jrleeman/NSSL_EFM/Hardware/Analog_PCB/Renders/PCB_Back.png

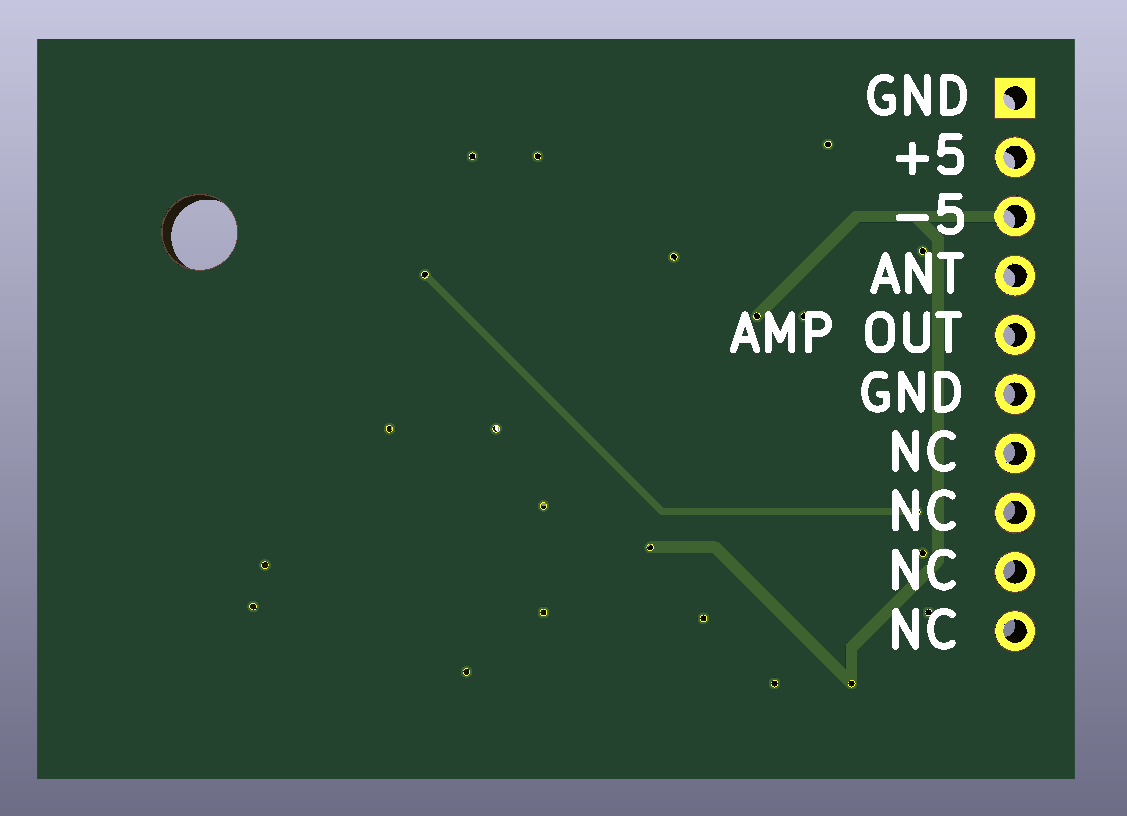
Hardware/Analog_PCB/Renders/PCB_Back.png
