jrleeman/NSSL_EFM/Hardware/Analog_PCB/Renders/PCB_Front.png

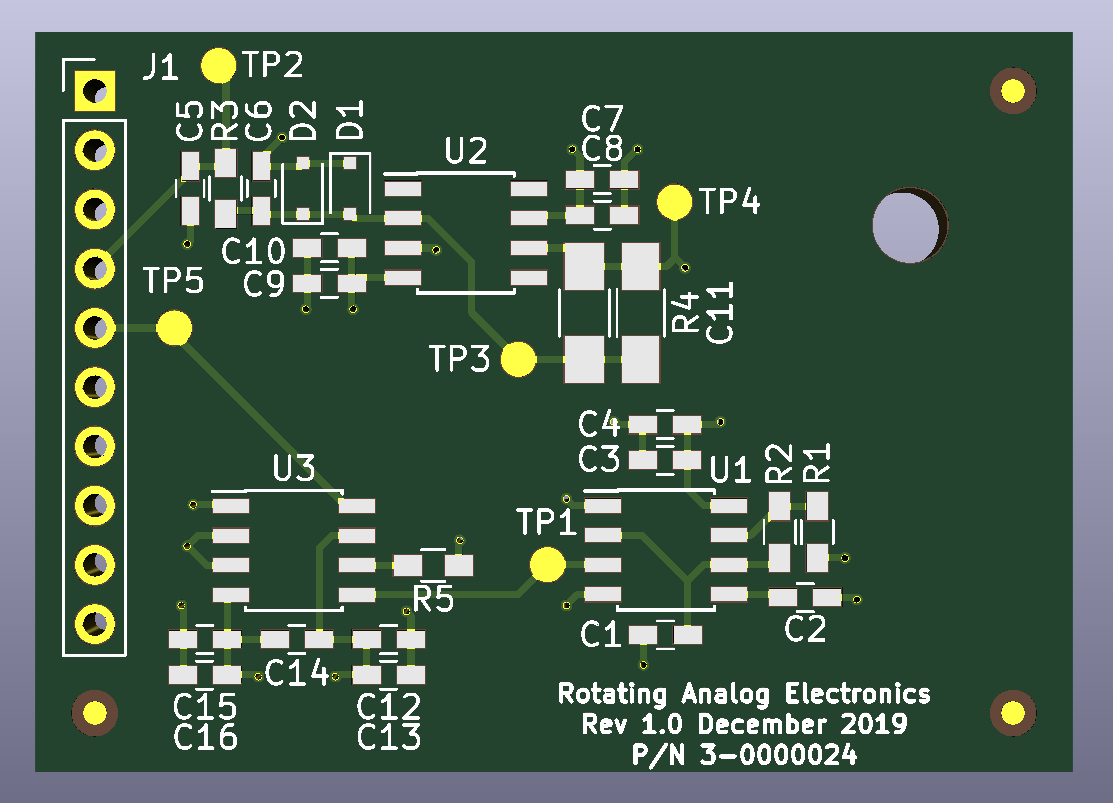
Hardware/Analog_PCB/Renders/PCB_Front.png
