jrleeman/NSSL_EFM/Hardware/Battery_PCB/Renders/PCB_Back.png

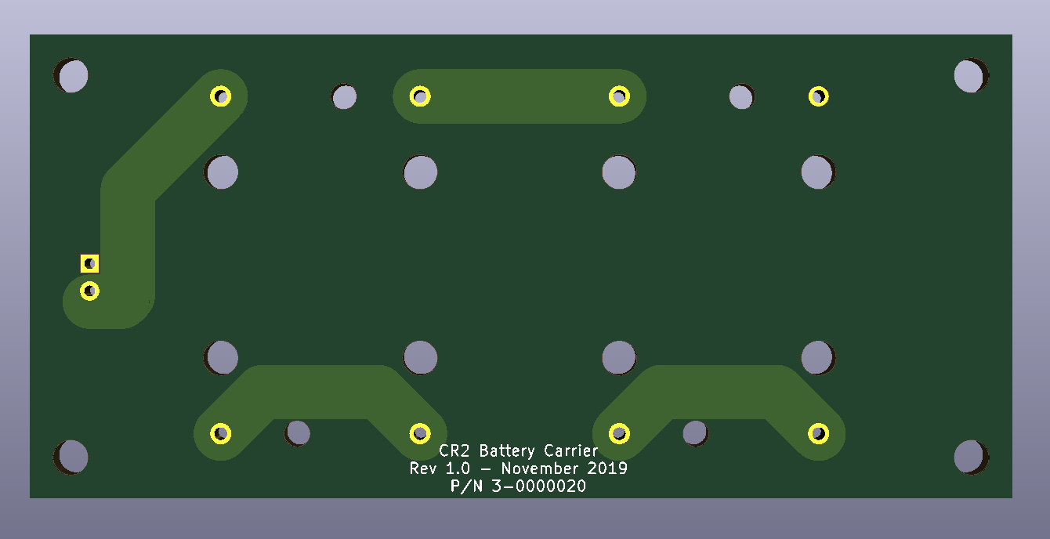
Hardware/Battery_PCB/Renders/PCB_Back.png
