jrleeman/NSSL_EFM/Hardware/Battery_PCB/Renders/PCB_Front.png

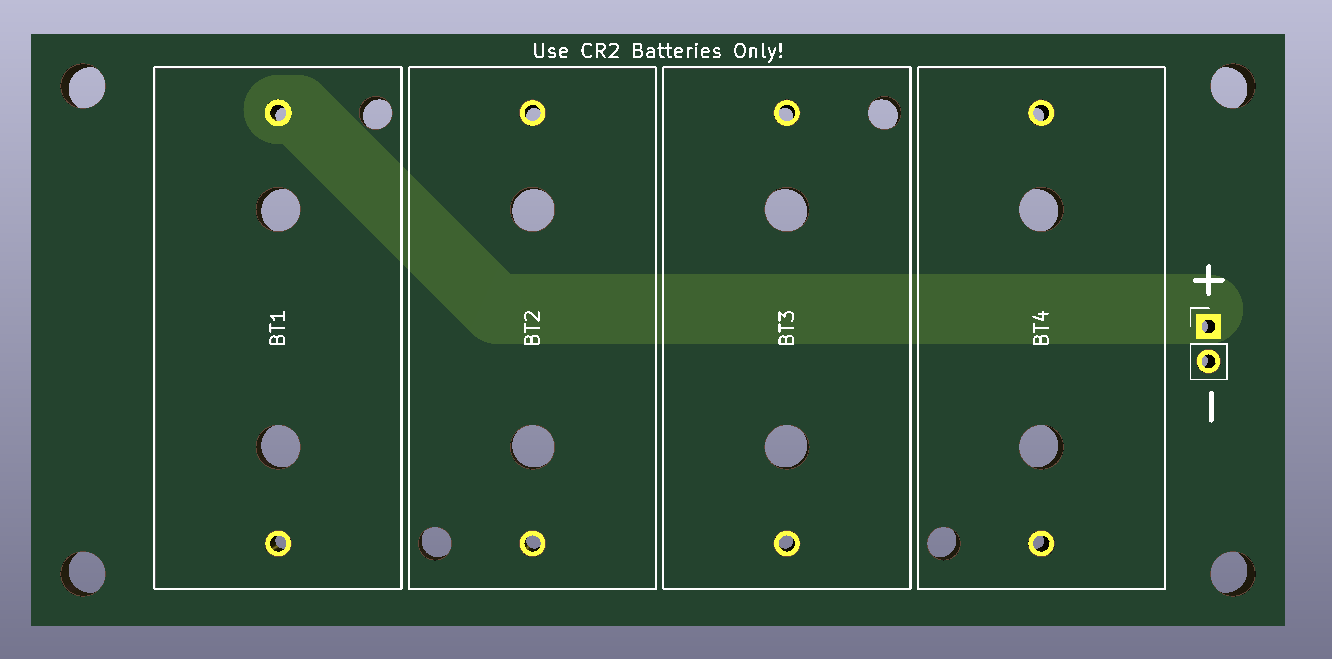
Hardware/Battery_PCB/Renders/PCB_Front.png
