jrleeman/NSSL_EFM/Hardware/Control_PCB/Renders/PCB_Back.png

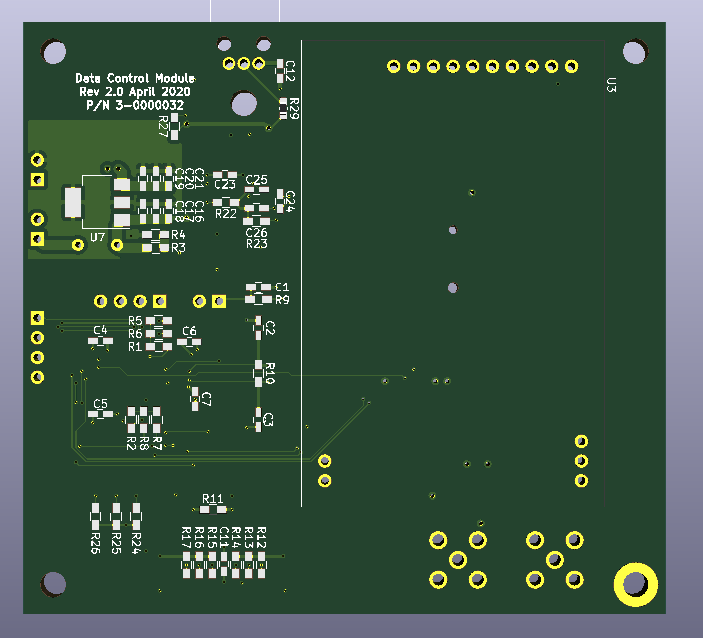
Hardware/Control_PCB/Renders/PCB_Back.png
