jrleeman/NSSL_EFM/Hardware/Control_PCB/Renders/PCB_Front.png

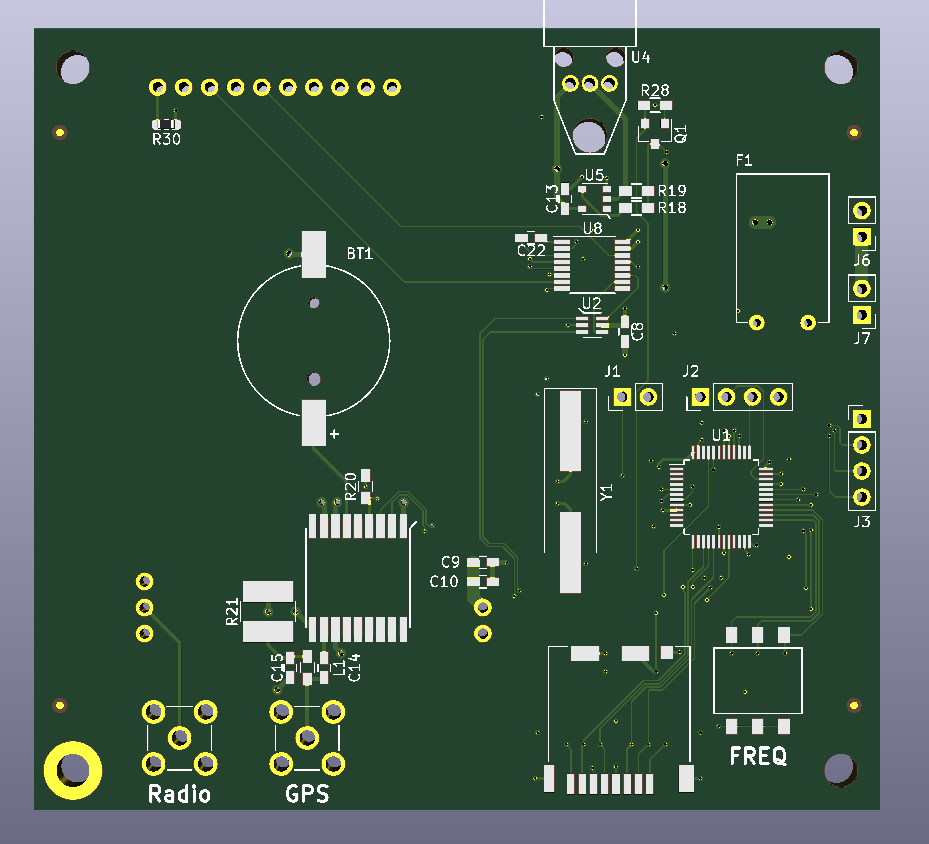
Hardware/Control_PCB/Renders/PCB_Front.png
