jrleeman/NSSL_EFM/Hardware/Cutdown_PCB/Renders/PCB_Back.png

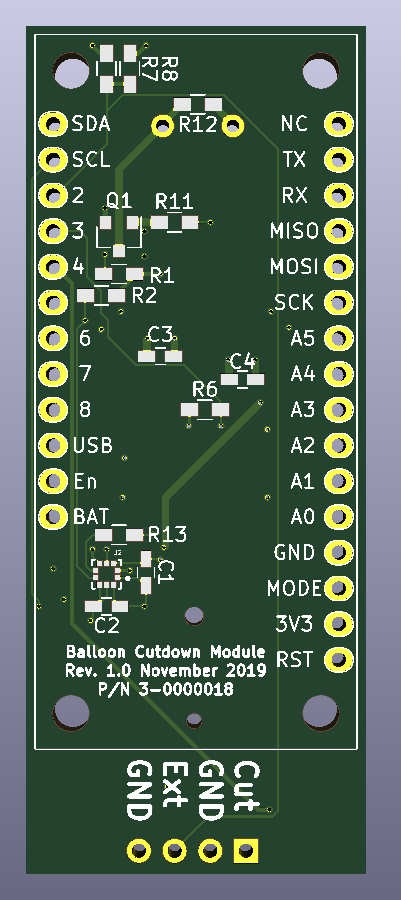
Hardware/Cutdown_PCB/Renders/PCB_Back.png
