jrleeman/NSSL_EFM/Hardware/Cutdown_PCB/Renders/PCB_Front.png

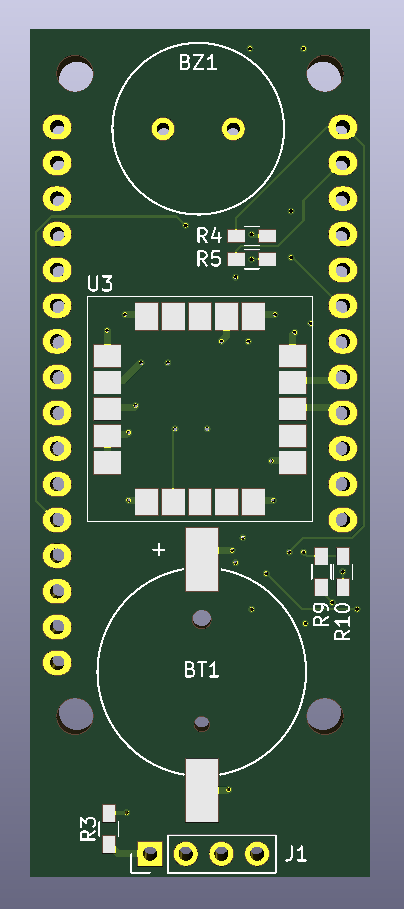
Hardware/Cutdown_PCB/Renders/PCB_Front.png
