jrleeman/NSSL_EFM/Hardware/Cutdown_Power_PCB/Renders/PCB_Back.png

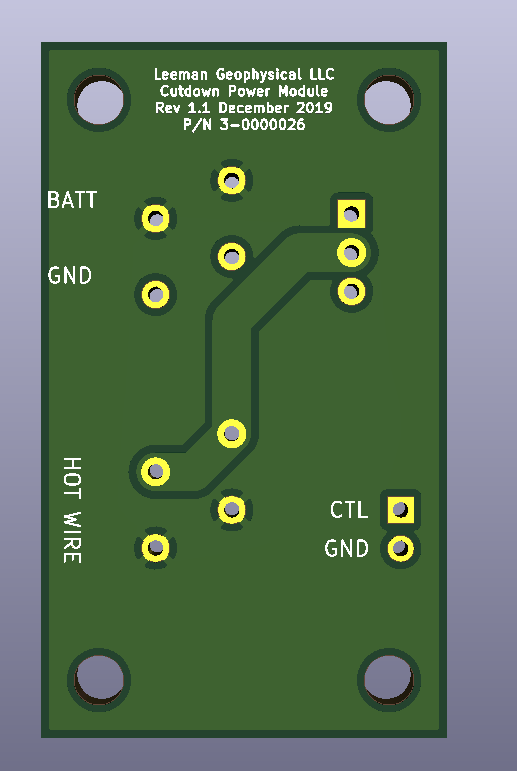
Hardware/Cutdown_Power_PCB/Renders/PCB_Back.png
