jrleeman/NSSL_EFM/Hardware/Cutdown_Power_PCB/Renders/PCB_Front.png

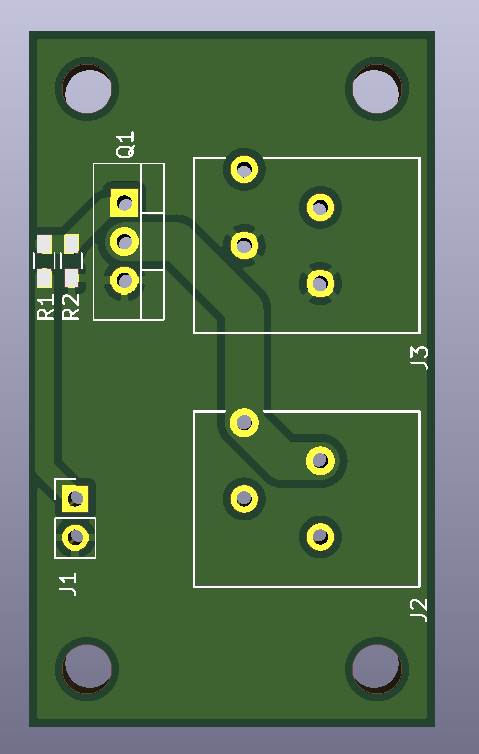
Hardware/Cutdown_Power_PCB/Renders/PCB_Front.png
