jrleeman/NSSL_EFM/Hardware/Digital_PCB/Renders/PCB_Back.png

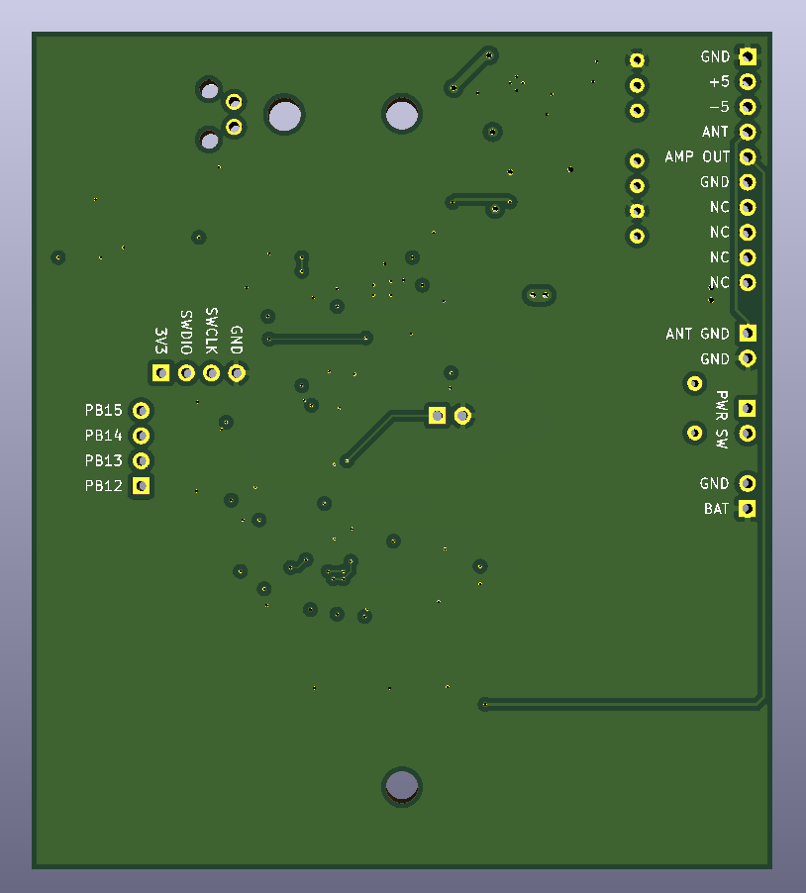
Hardware/Digital_PCB/Renders/PCB_Back.png
