jrleeman/NSSL_EFM/Hardware/Digital_PCB/Renders/PCB_Front.png

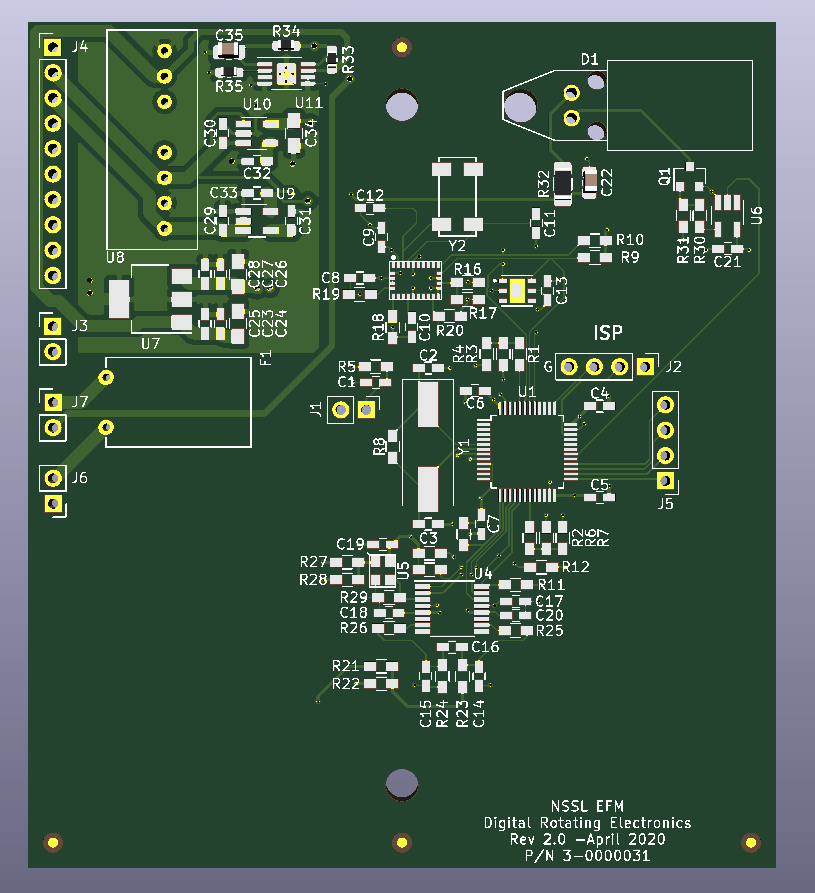
Hardware/Digital_PCB/Renders/PCB_Front.png
