jrleeman/NSSL_EFM/Hardware/Motor_Control_PCB/Renders/PCB_Back.png

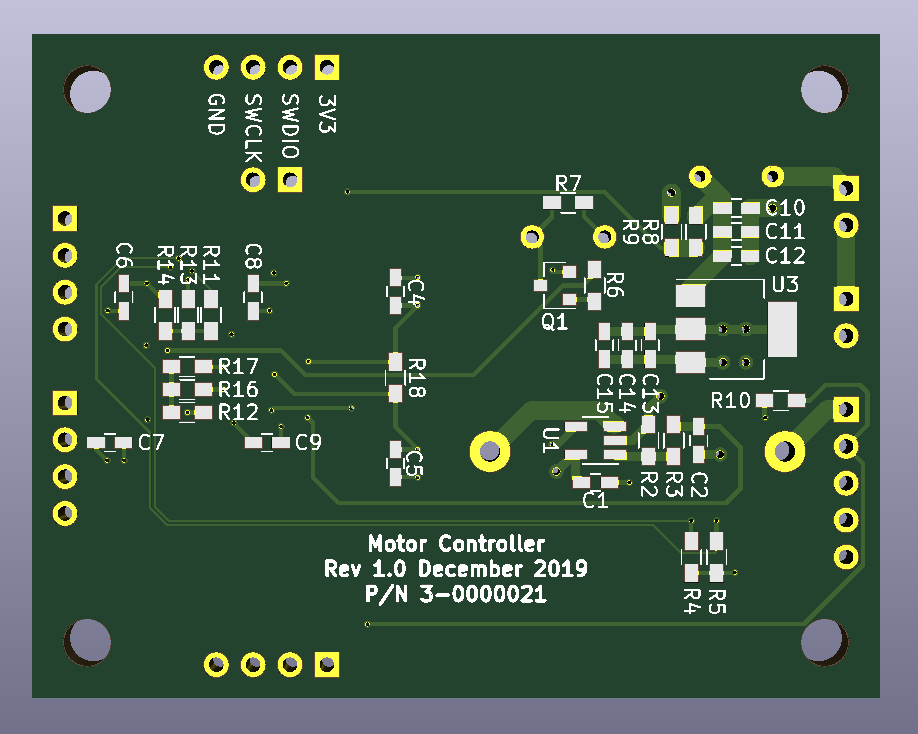
Hardware/Motor_Control_PCB/Renders/PCB_Back.png
