jrleeman/NSSL_EFM/Hardware/Motor_Control_PCB/Renders/PCB_Front.png

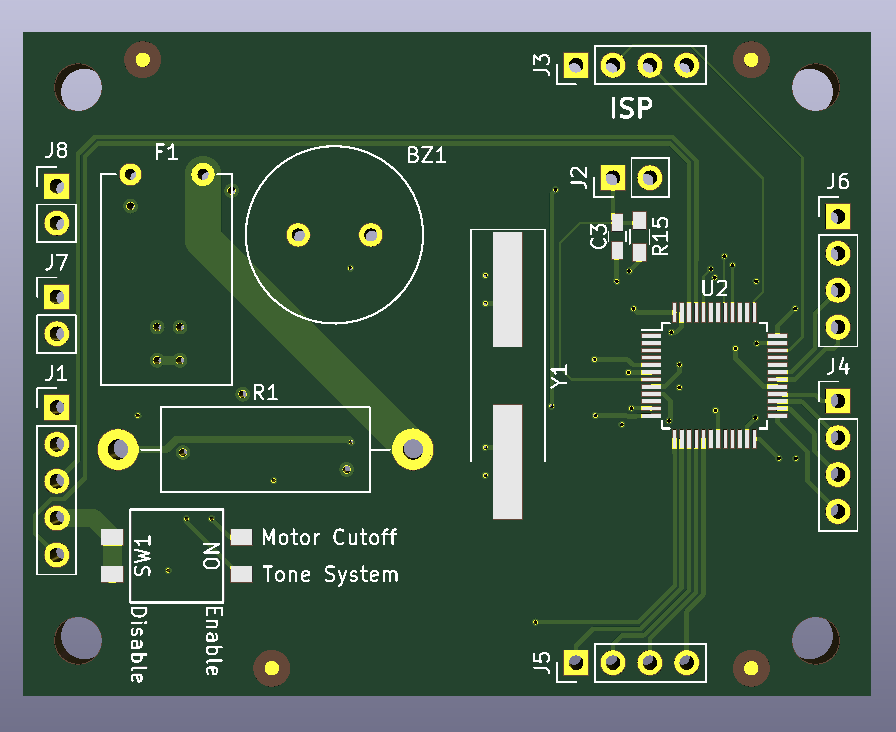
Hardware/Motor_Control_PCB/Renders/PCB_Front.png
