jrleeman/NSSL_EFM/Hardware/Digital_PCB/PDFs/pcb.pdf

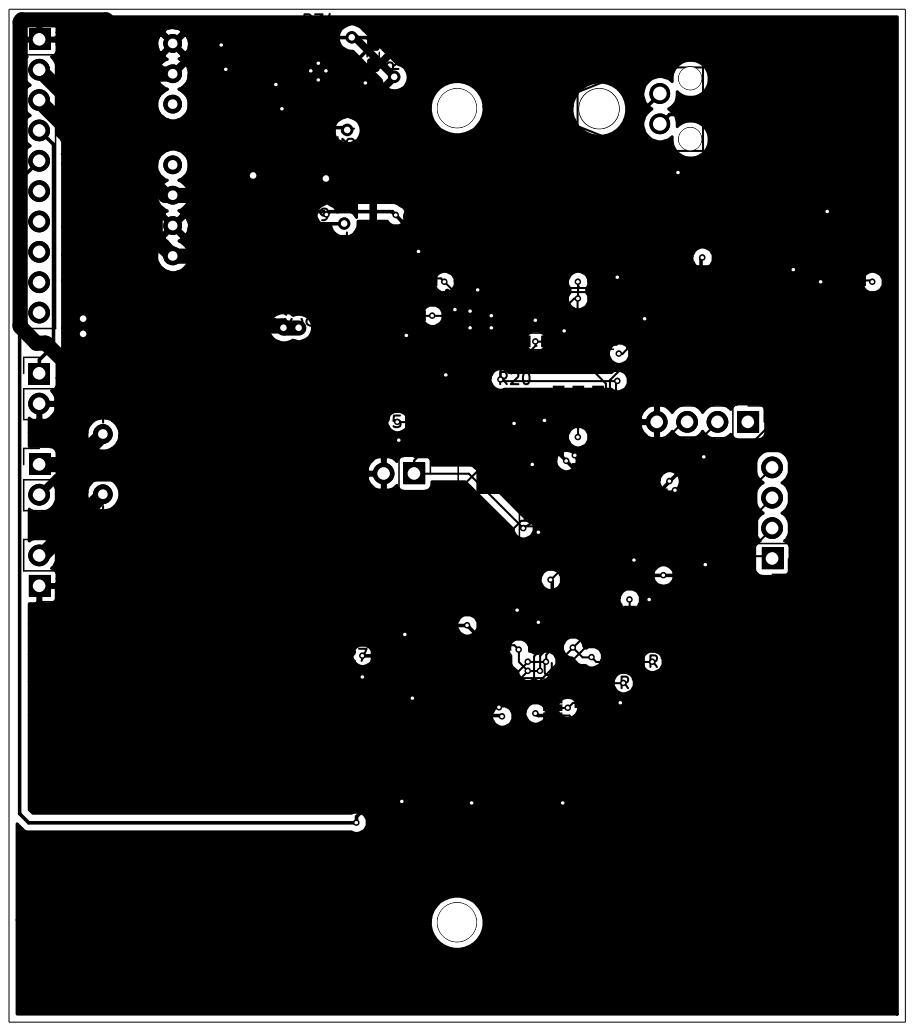
[picture p15: page 1]
