jrleeman/NSSL_EFM/Hardware/Control_PCB/PDFs/pcb.pdf

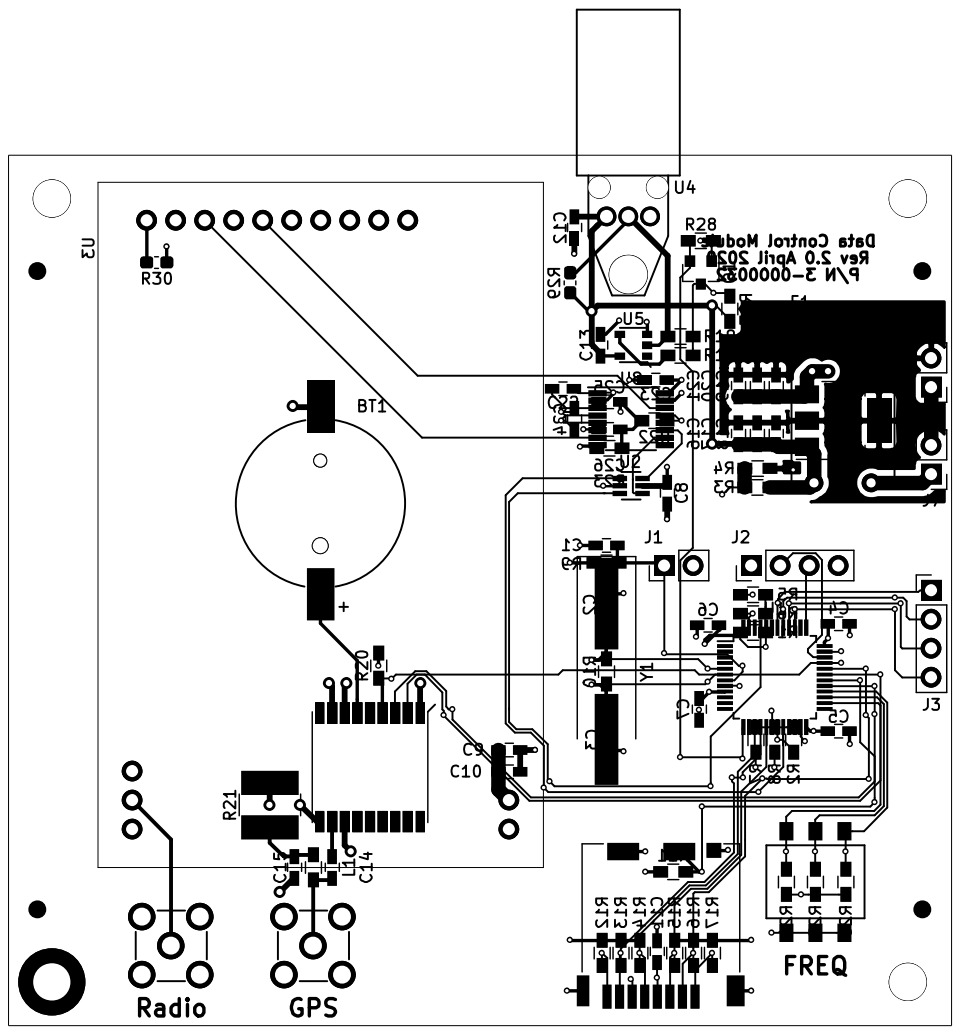
[picture p21: page 1]
