jrleeman/NSSL_EFM/Hardware/Cutdown_PCB/PDFs/schematic.pdf

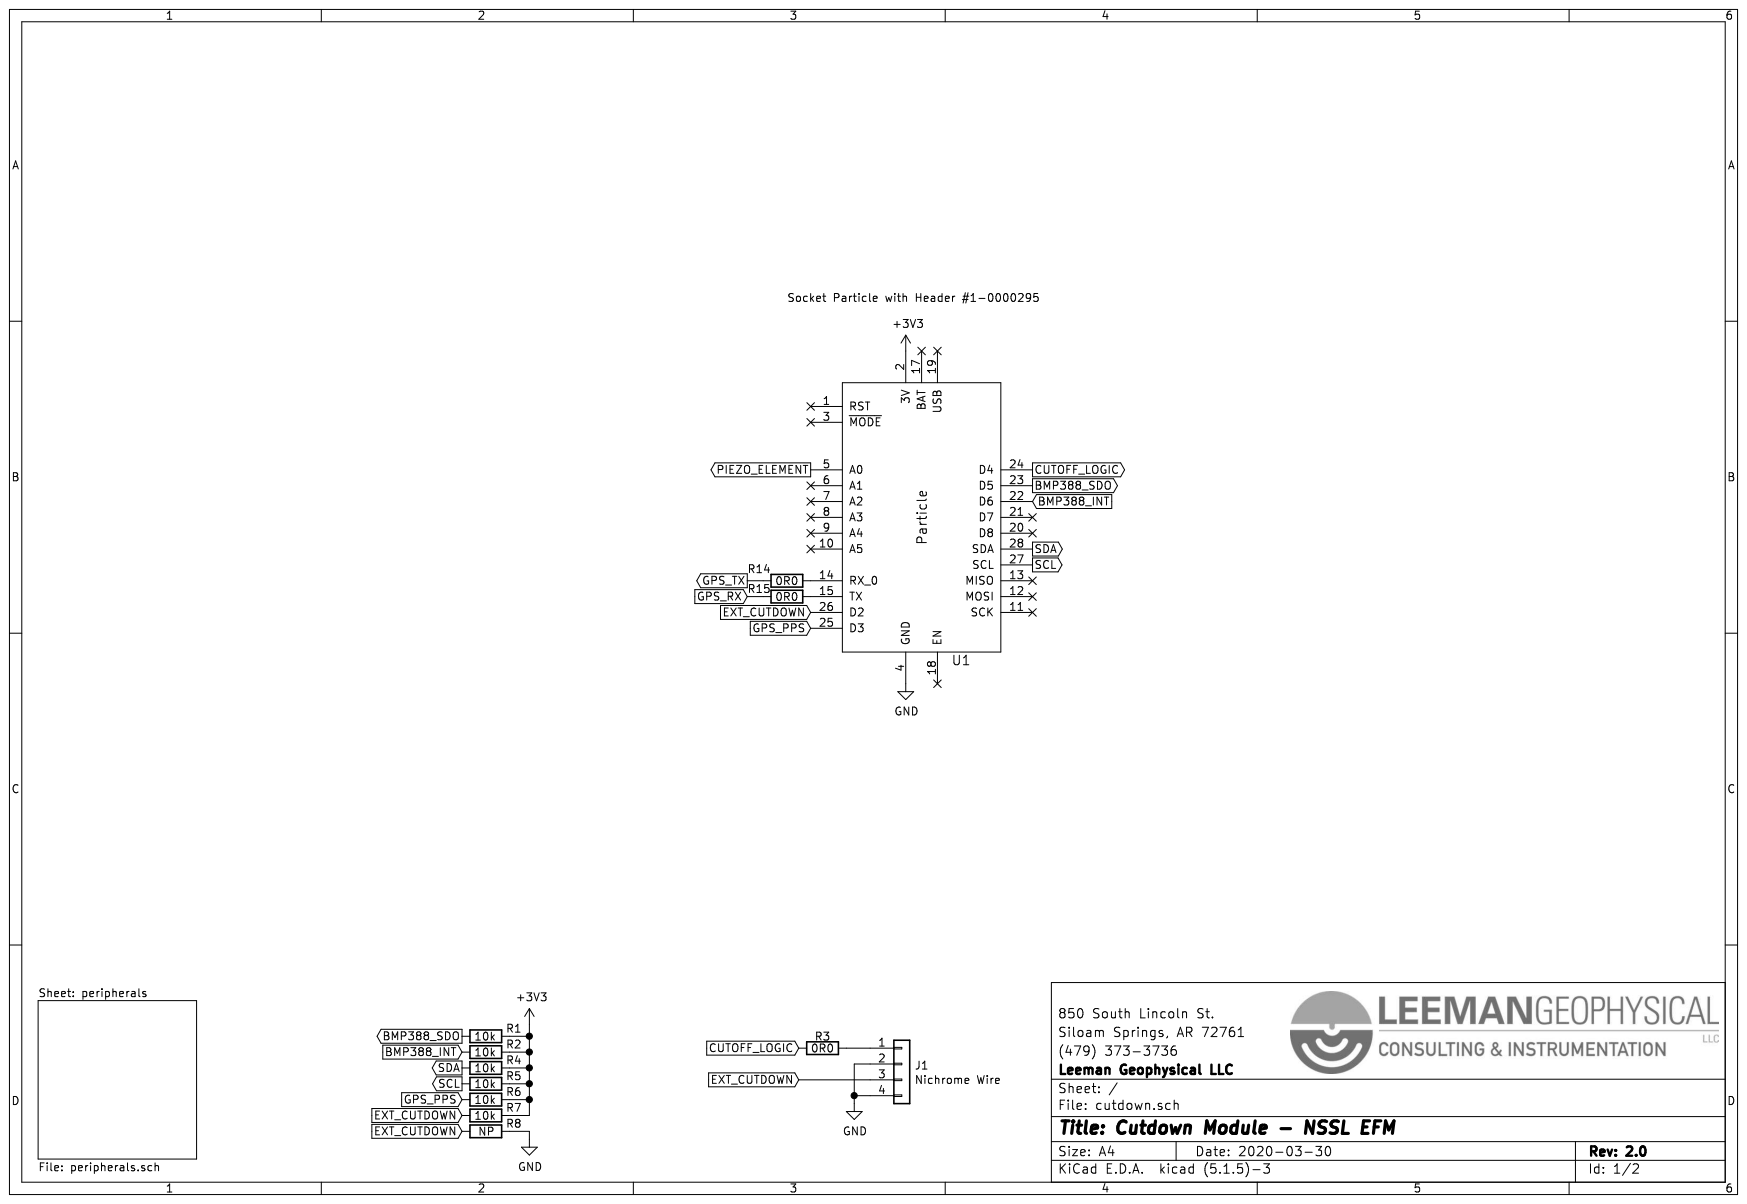
[picture p28: page 1]

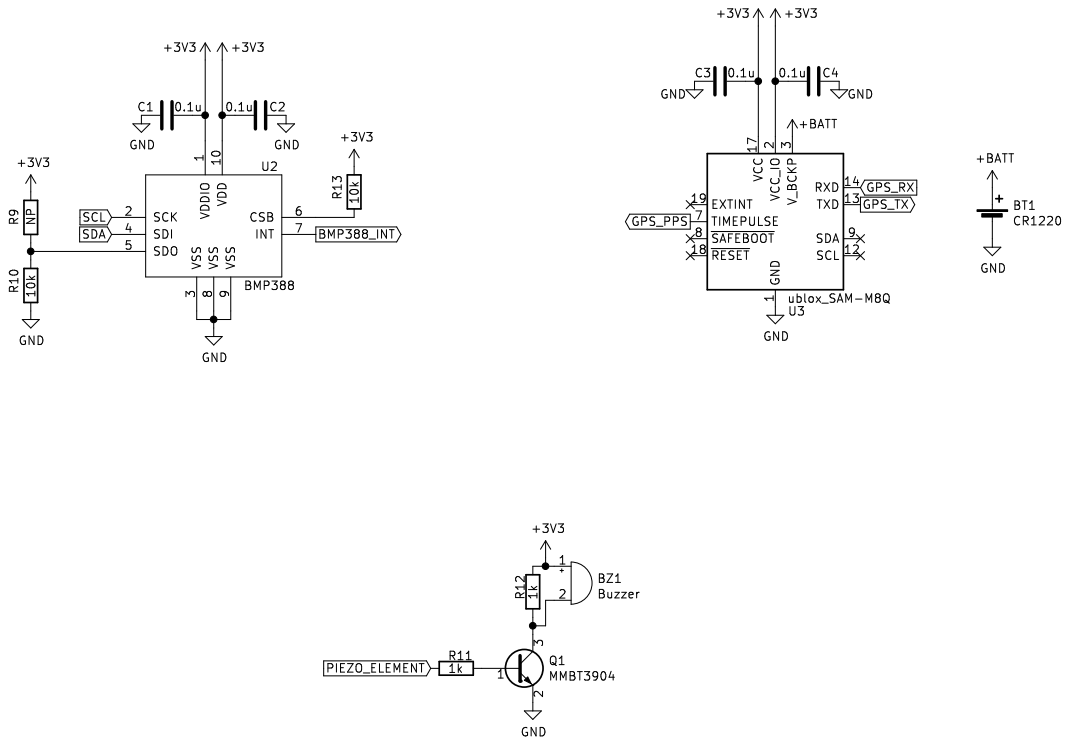
[picture p29: page 2]
