jrleeman/NSSL_EFM/Hardware/Analog_PCB/PDFs/pcb.pdf

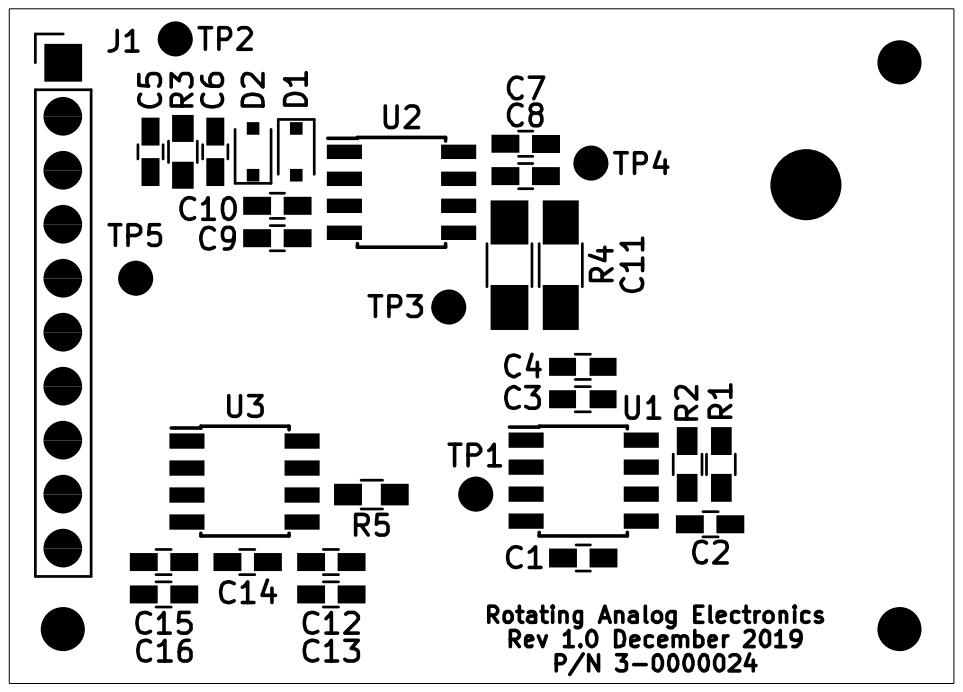
[picture p30: page 1]
