jrleeman/NSSL_EFM/Hardware/Analog_PCB/PDFs/schematic.pdf

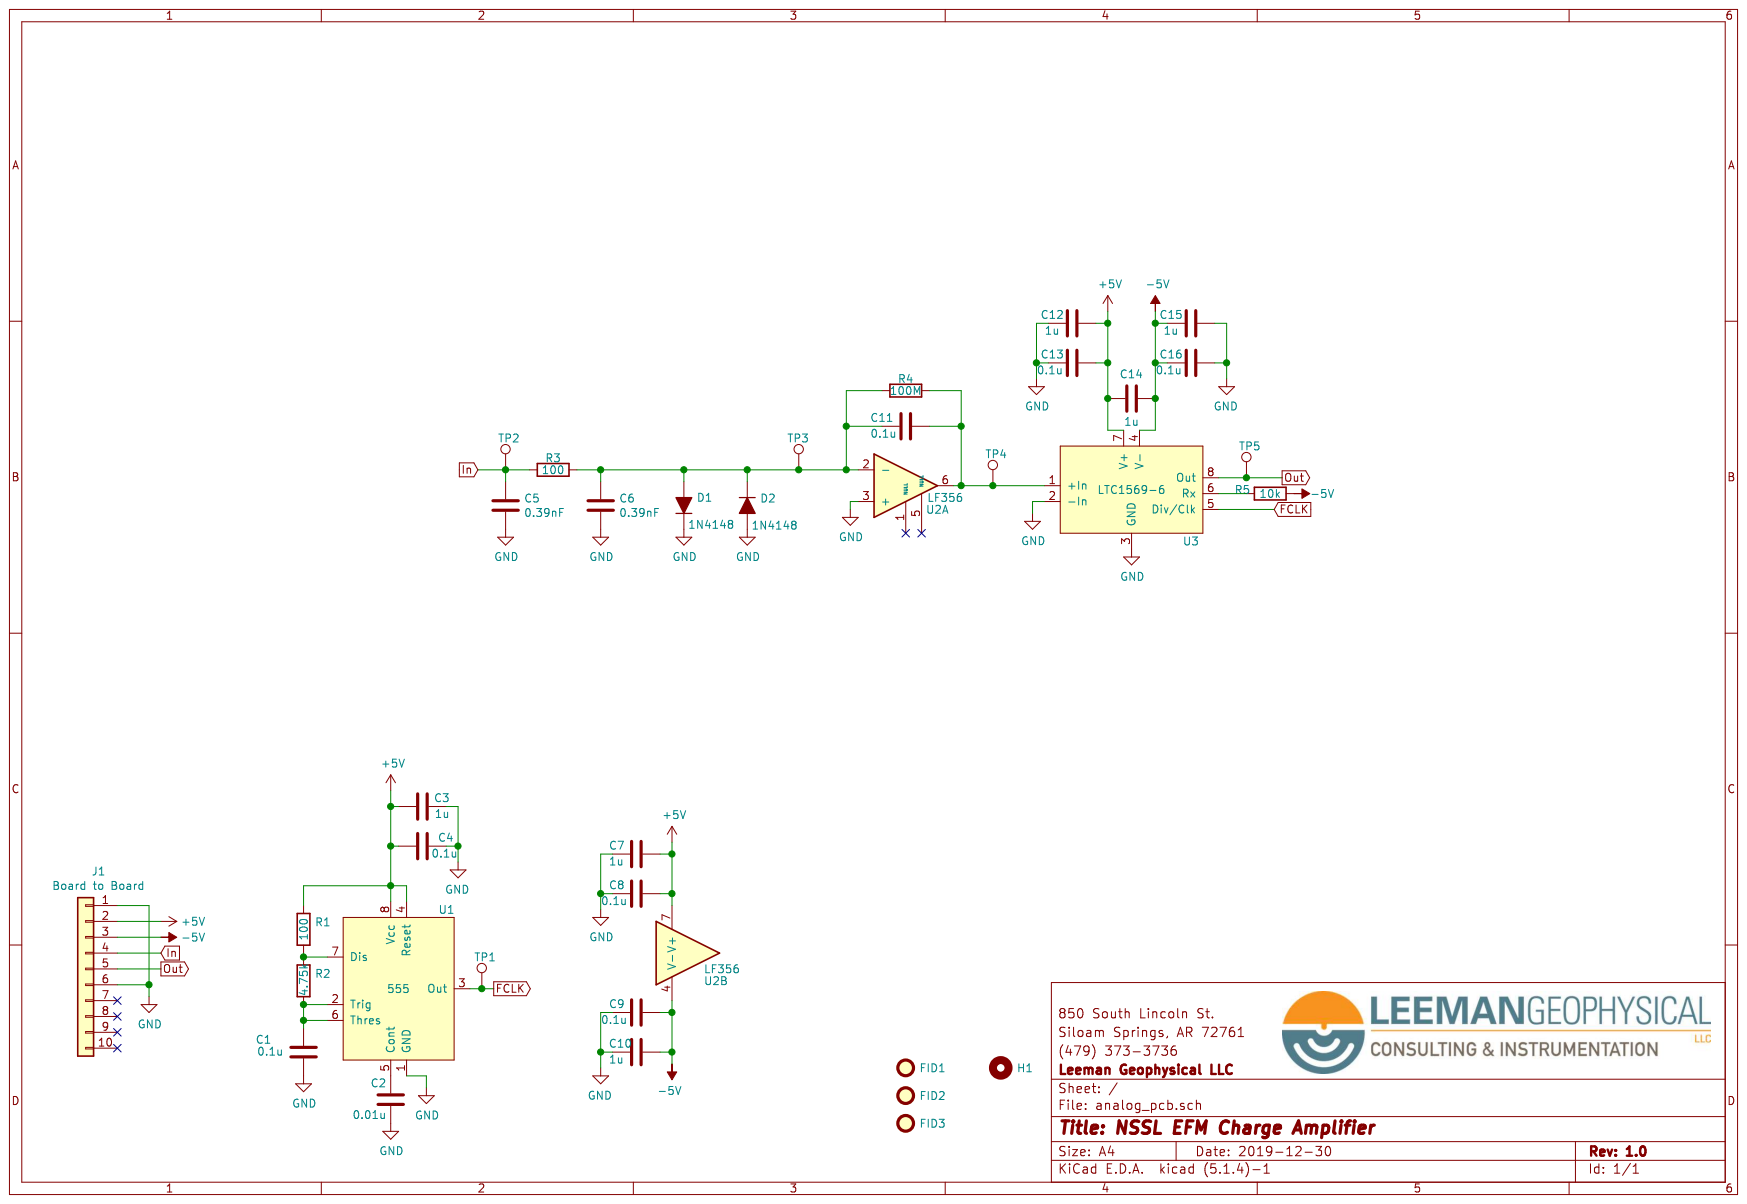
[picture p31: page 1]
