jrleeman/NSSL_EFM/Hardware/Cutdown_Power_PCB/PDFs/schematic.pdf

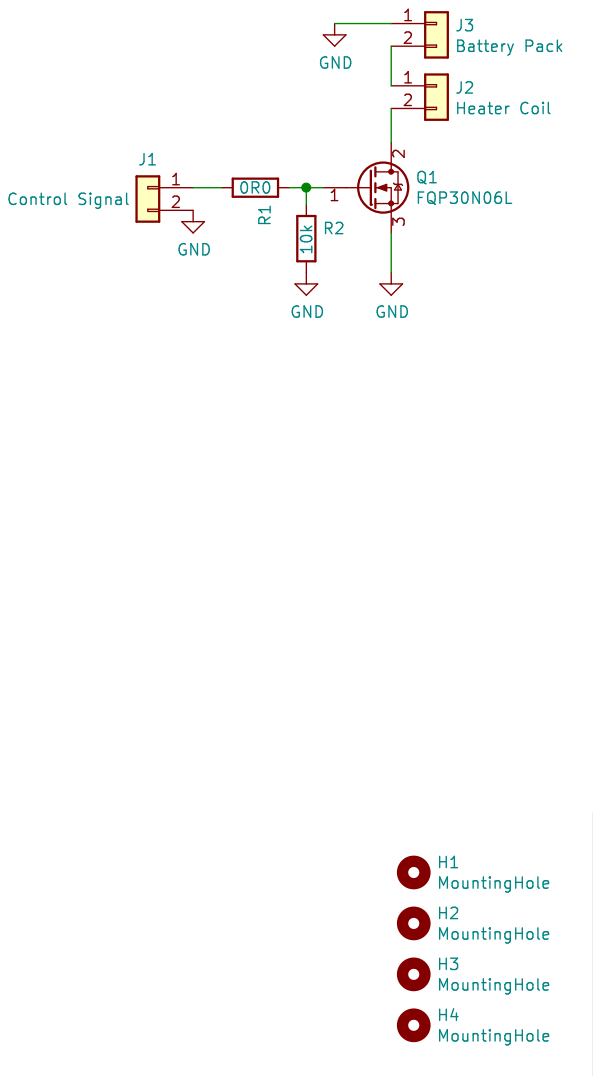
[picture p32: page 1]
