jrleeman/NSSL_EFM/Hardware/Cutdown_PCB/PDFs/pcb.pdf

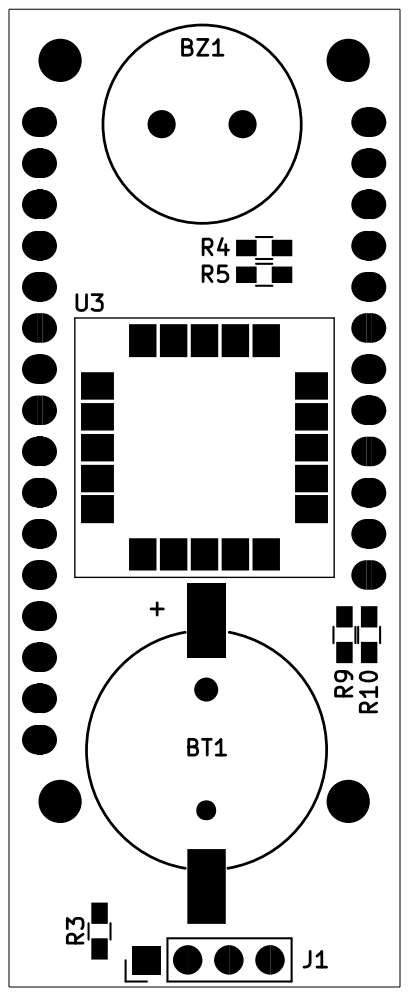
[picture p33: page 1]
