jrleeman/NSSL_EFM/Hardware/Motor_Control_PCB/PDFs/pcb.pdf

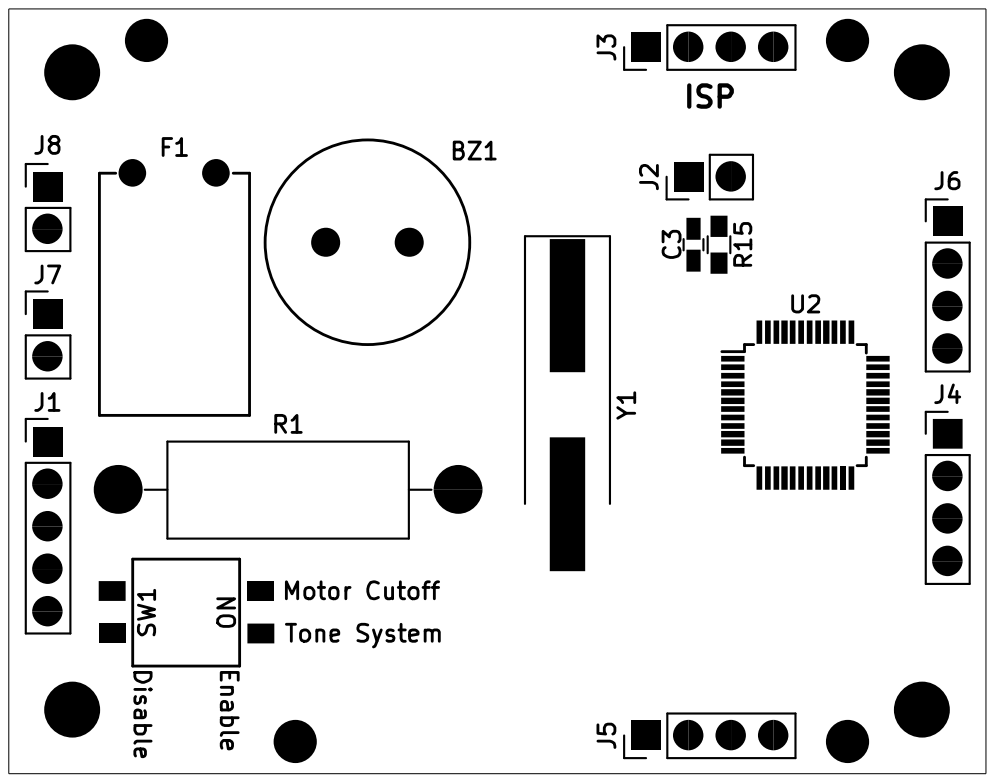
[picture p34: page 1]
