jrleeman/NSSL_EFM/Hardware/Motor_Control_PCB/PDFs/schematic.pdf

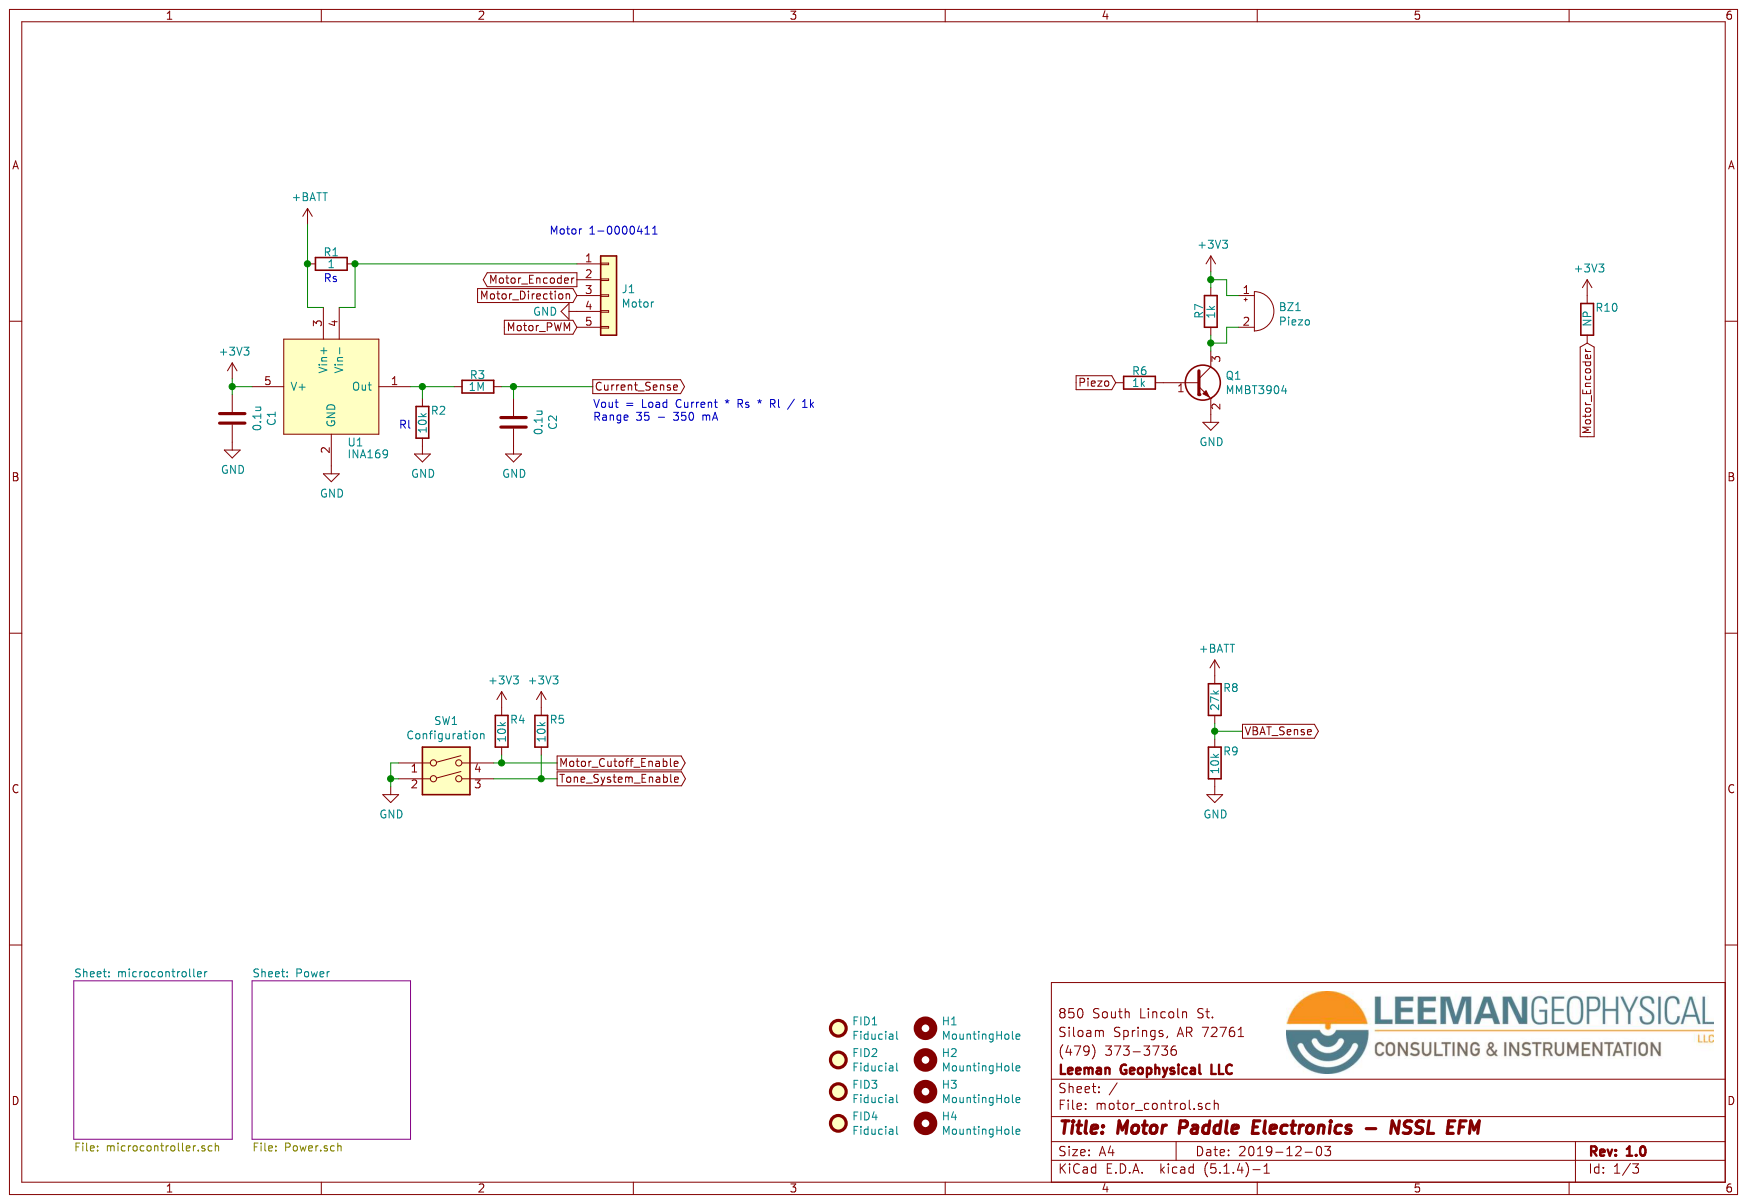
[picture p35: page 1]

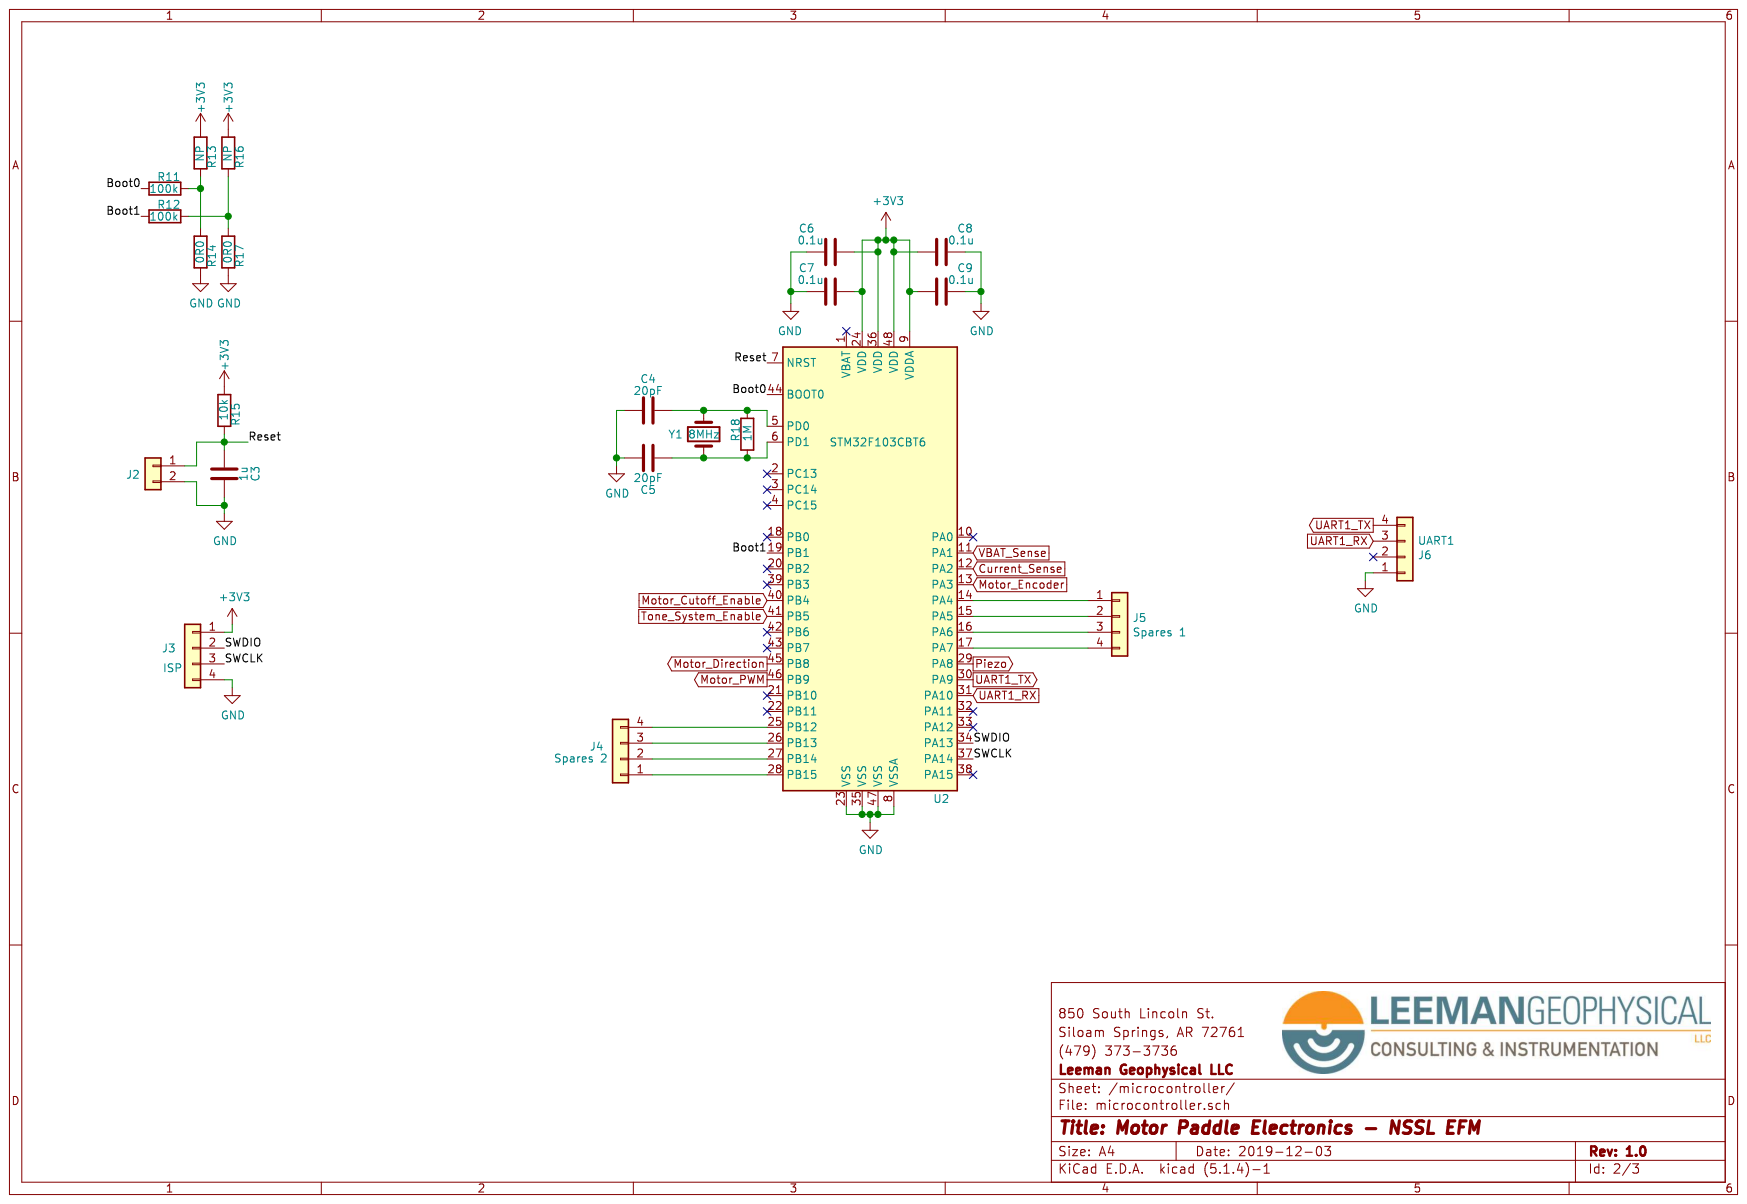
[picture p36: page 2]

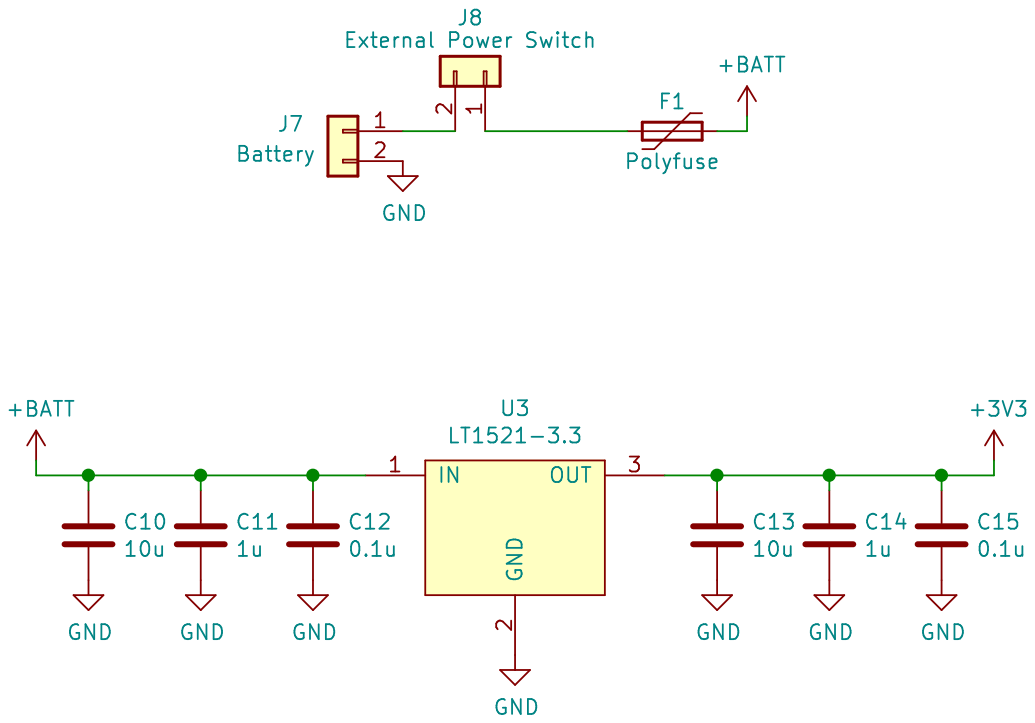
[picture p37: page 3]
