jrleeman/NSSL_EFM/Hardware/Battery_PCB/PDFs/pcb.pdf

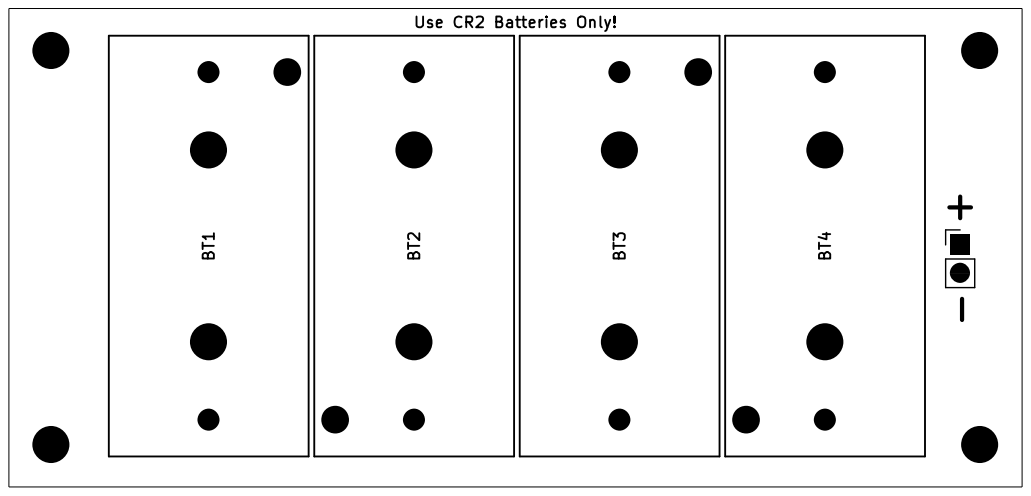
[picture p38: page 1]
