jrleeman/NSSL_EFM/Hardware/Battery_PCB/PDFs/schematic.pdf

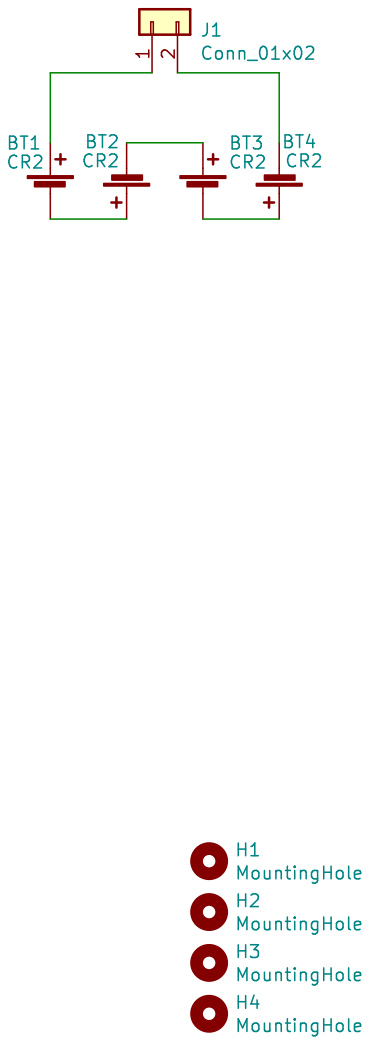
[picture p39: page 1]
