jrleeman/NSSL_EFM/Hardware/Digital_PCB/KiCAD_Project/digital_pcb/digital_pcb.kicad_pcb

## KiCad design Hardware/Digital_PCB/KiCAD_Project/digital_pcb/digital_pcb.kicad_pcb (2020-12-17)

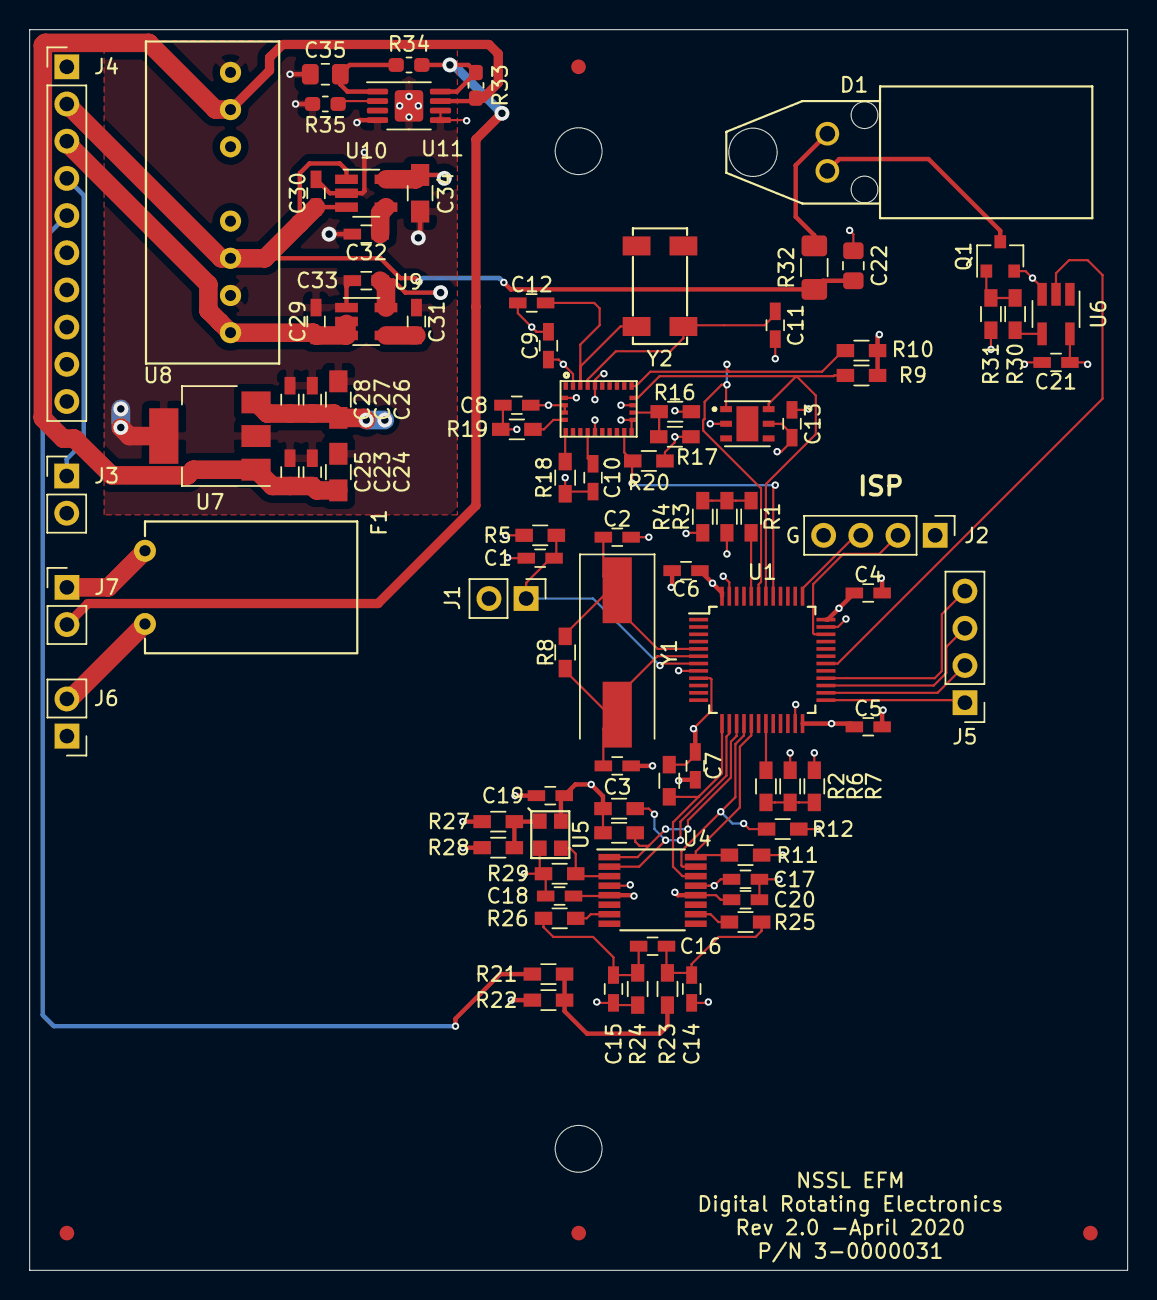
[picture p40: board digital_pcb.kicad_pcb from above]

Board: 4 copper layers, 75.0 x 84.8 mm, 99 parts (0 on the bottom side), 55 nets.

Parts:
C1, C24, C27: 1u; C_0603_HandSoldering
C2, C3: 20pF; C_0603_HandSoldering
C4, C5, C6, C7, C8, C9, C10, C13, C17, C18, C20, C21, C25, C28, C30: 0.1u; C_0603_HandSoldering
C11, C12: 22pF; C_0603_HandSoldering
C14, C15, C16: NP; C_0603_HandSoldering
C19: 0.01u; C_0603_HandSoldering
C22, C35: 10u; C_0805_2012Metric_Pad1.15x1.40mm_HandSolder
C23, C26, C34: 10u; C_0805_HandSoldering
C29, C33: 2.2u; C_0603_HandSoldering
C31, C32: 10n; C_0603_HandSoldering
D1: IF-E96E; IF_E96E
F1: Polyfuse; RGEF250
FID1, FID2, FID3, FID4: Fiducial; Fiducial_1mm_Dia_2mm_Outer
H1, H2: MountingHole; MountingHole_3.2mm_M3_ISO7380
J1, J3: Conn_01x02; Pin_Header_Straight_1x02_Pitch2.54mm
J2: ISP; Pin_Header_Straight_1x04_Pitch2.54mm
J4: Board to Board; Pin_Header_Straight_1x10_Pitch2.54mm
J5: Spare 1; Pin_Header_Straight_1x04_Pitch2.54mm
J6: Power; Pin_Header_Straight_1x02_Pitch2.54mm
J7: Power Switch; Pin_Header_Straight_1x02_Pitch2.54mm
Q1: MMBT3904; SOT-23
R1, R2: 100k; R_0603_HandSoldering
R3, R6, R16, R20, R28, R29: NP; R_0603_HandSoldering
R4, R7, R23, R24, R25, R26: 0R0; R_0603_HandSoldering
R5, R9, R10, R11, R12, R13, R14, R15, R17, R18, R19, R21, R22, R27: 10k; R_0603_HandSoldering
R8: 1M; R_0603_HandSoldering
R30: 3.9k; R_0603_HandSoldering
R31: 33k; R_0603_HandSoldering
R32: 165; R_1206_3216Metric_Pad1.42x1.75mm_HandSolder
R33: 0R0; R_0603_1608Metric_Pad1.05x0.95mm_HandSolder
R34: 470k; R_0603_1608Metric_Pad1.05x0.95mm_HandSolder
R35: 10k; R_0603_1608Metric_Pad1.05x0.95mm_HandSolder
U1: STM32F103CBTx; LQFP-48_7x7mm_Pitch0.5mm
U2: BNO055; LGA28R50P4X10_380X520X100
U3: HTU21D; SON100P300X300X90-7N
U4: ADS1220; TSSOP-16_4.4x5mm_Pitch0.65mm
U5: KC2520B-C2
U6: SN74LVC1G17-EP; SOT-23-5_HandSoldering
U7: LT1521-3.3; SOT-223-3_TabPin2
U8: TEC 2-0921; TEC2
U9: TPS723; SOT-23-5_HandSoldering
U10: TPS793; SOT-23-5_HandSoldering
U11: TPS1H000; MSOP-8-1EP_3x3mm_P0.65mm_EP1.95x2.15mm
Y1: 8MHz; Crystal_SMD_HC49-SD
Y2: 32.768kHz; 4-SOJ

Connections:
+2V5: C20.1, C34.1, U4.12, U10.5
+3V3: C4.1, C5.1, C6.1, C7.1, C8.1, C9.1, C13.1, C17.1, C19.1, C21.1, C26.1, C27.1, C28.1, J2.1, R3.1, R5.1, R6.1, R9.1, R10.1, R11.1, R12.1, R13.1, R14.1, R15.1, R16.2, R20.2, R27.2, U1.9, U1.24, U1.36, U1.48, U2.3, U2.4, U2.28, U3.5, U4.13, U5.4, U6.5, U7.3
+5V: C22.1, C30.1, J4.2, R32.2, U8.6, U10.1, U10.3
+BATT: C23.1, C24.1, C25.1, R33.1, U7.1, U8.2, U11.7
-2V5: C18.1, C33.1, U4.5, U9.5
-5V: C29.1, J4.3, U8.8, U9.2, U9.3
/Boot0: R1.2, U1.44
/Boot1: R2.2, U1.19
/Peripherals/BNO_ADDR: R16.1, R17.2, U2.17
/Reset: C1.2, J1.1, R5.2, U1.7
/SWCLK: J2.3, U1.37
/SWDIO: J2.2, U1.34
ADC_CS: R14.2, U1.14, U4.2
ADC_~DRDY: R15.2, U1.13, U4.14
AMP_IN: J3.1, J4.4
AMP_OUT: J4.5, R21.2
GND: C1.1, C2.2, C3.2, C4.2, C5.2, C6.2, C7.2, C8.2, C9.2, C10.2, C11.1, C12.1, C13.2, C14.2, C15.2, C17.2, C18.2, C19.2, C20.2, C21.2, C22.2, C23.2, C24.2, C25.2, C26.2, C27.2, C28.2, C29.2, C30.2, C31.2, C32.2, C33.2, C34.2, C35.2, J1.2, J2.4, J3.2, J4.1, J4.6, J6.1, Q1.2, R4.2, R7.2, R17.1, R18.1, R19.1, R22.1, R24.2, R28.2, R29.1, R31.1, R35.2, U1.8, U1.23, U1.35, U1.47, U2.2, U2.10, U2.15, U2.16, U2.18, U2.25, U3.2, U4.4, U5.2, U6.3, U7.2, U8.1, U8.7, U9.1, U10.2, U11.4, U11.5, U11.6, U11.9
I2C_SCL: R9.2, U1.42, U2.19, U3.6
I2C_SDA: R10.2, U1.43, U2.20, U3.1
IMU_INT: R20.1, U1.41, U2.14
unnamed: C2.1, R8.1, U1.5, Y1.1
unnamed: C3.1, R8.2, U1.6, Y1.2
unnamed: C10.1, U2.9
unnamed: C11.2, U2.26, Y2.1
unnamed: C12.2, U2.27, Y2.2
unnamed: C14.1, C16.1, R23.1, R25.2
unnamed: C15.1, C16.2, R24.1, R26.2
unnamed: C31.1, U9.4
unnamed: C32.1, U10.4
unnamed: C35.1, R34.1, U11.1
unnamed: D1.1, Q1.3
unnamed: D1.2, R32.1
unnamed: F1.1, J7.1
unnamed: F1.2, J6.2
unnamed: J5.1, U1.25
unnamed: J5.2, U1.26
unnamed: J5.3, U1.27
unnamed: J5.4, U1.28
unnamed: J7.2, R33.2, R34.2, U11.8
unnamed: Q1.1, R30.1, R31.2
unnamed: R1.1, R3.2, R4.1
unnamed: R2.1, R6.2, R7.1
unnamed: R18.2, U2.6
unnamed: R19.2, U2.5
unnamed: R21.1, R22.2, R23.2
unnamed: R25.1, U4.10
unnamed: R26.1, U4.7
unnamed: R27.1, R28.1, U5.1
unnamed: R29.2, U4.3, U5.3
unnamed: R30.2, U6.4
unnamed: R35.1, U11.2
SPI1_MISO: R12.2, U1.16, U4.15
SPI1_MOSI: R11.2, U1.17, U4.16
SPI1_SCLK: R13.2, U1.15, U4.1
UART1_TX: U1.30, U6.2
