jrleeman/NSSL_EFM/Hardware/Control_PCB/KiCAD_Project/control_pcb/control_pcb.kicad_pcb

## KiCad design Hardware/Control_PCB/KiCAD_Project/control_pcb/control_pcb.kicad_pcb (2020-03-31)

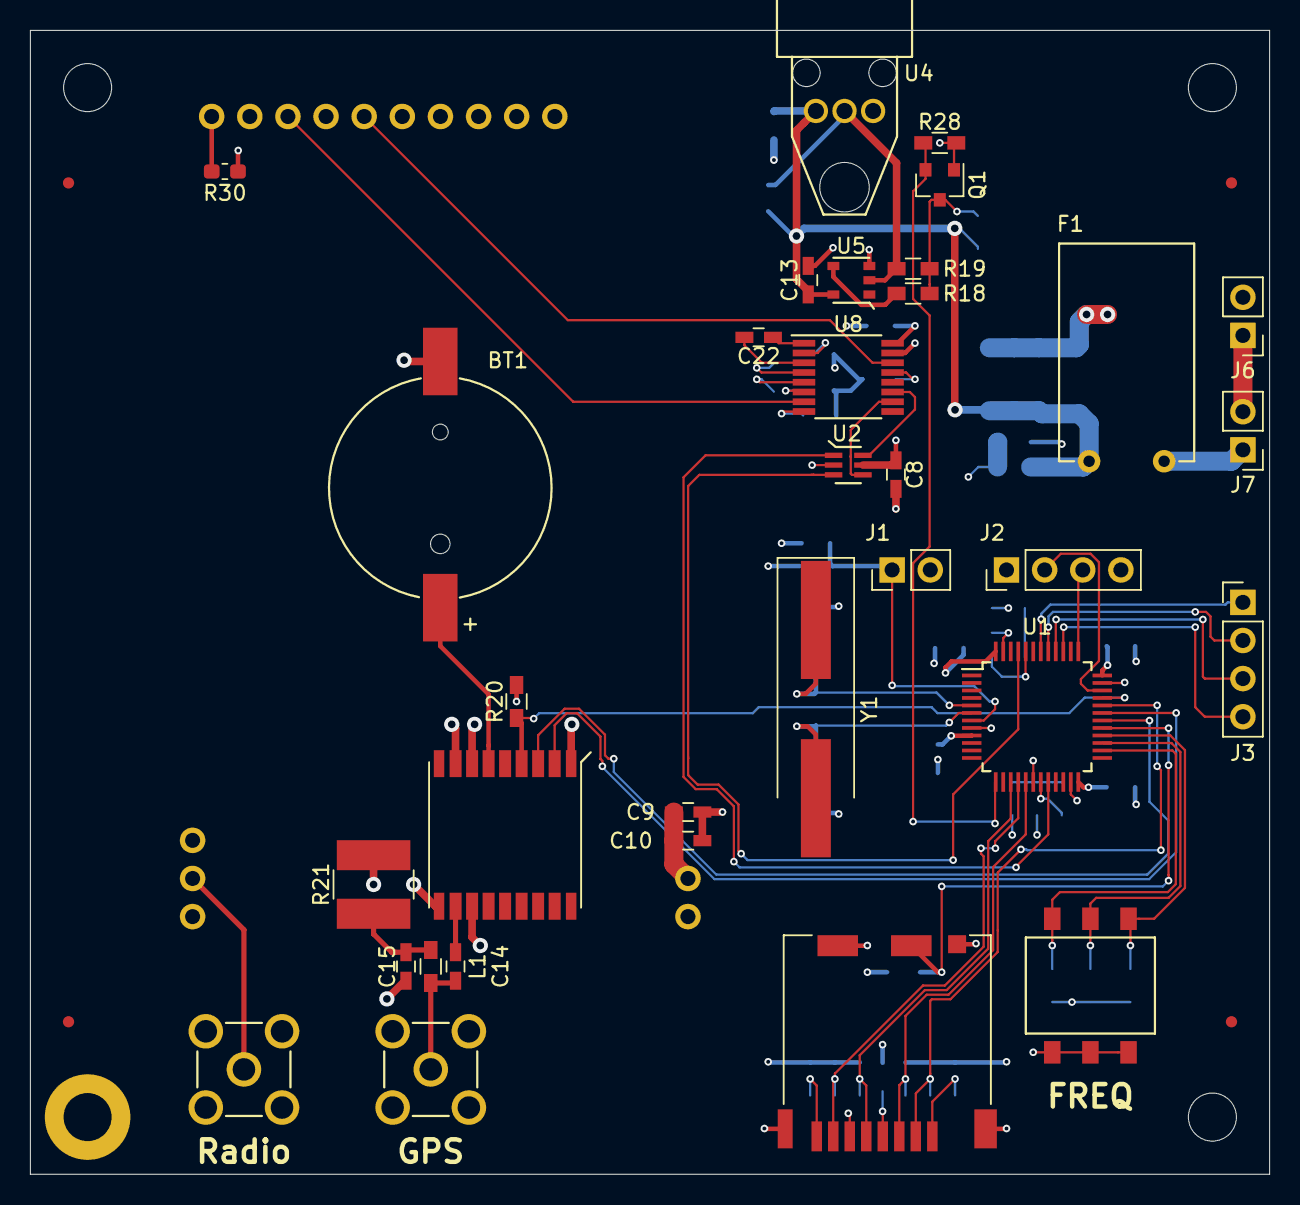
[picture p41: board control_pcb.kicad_pcb from above]

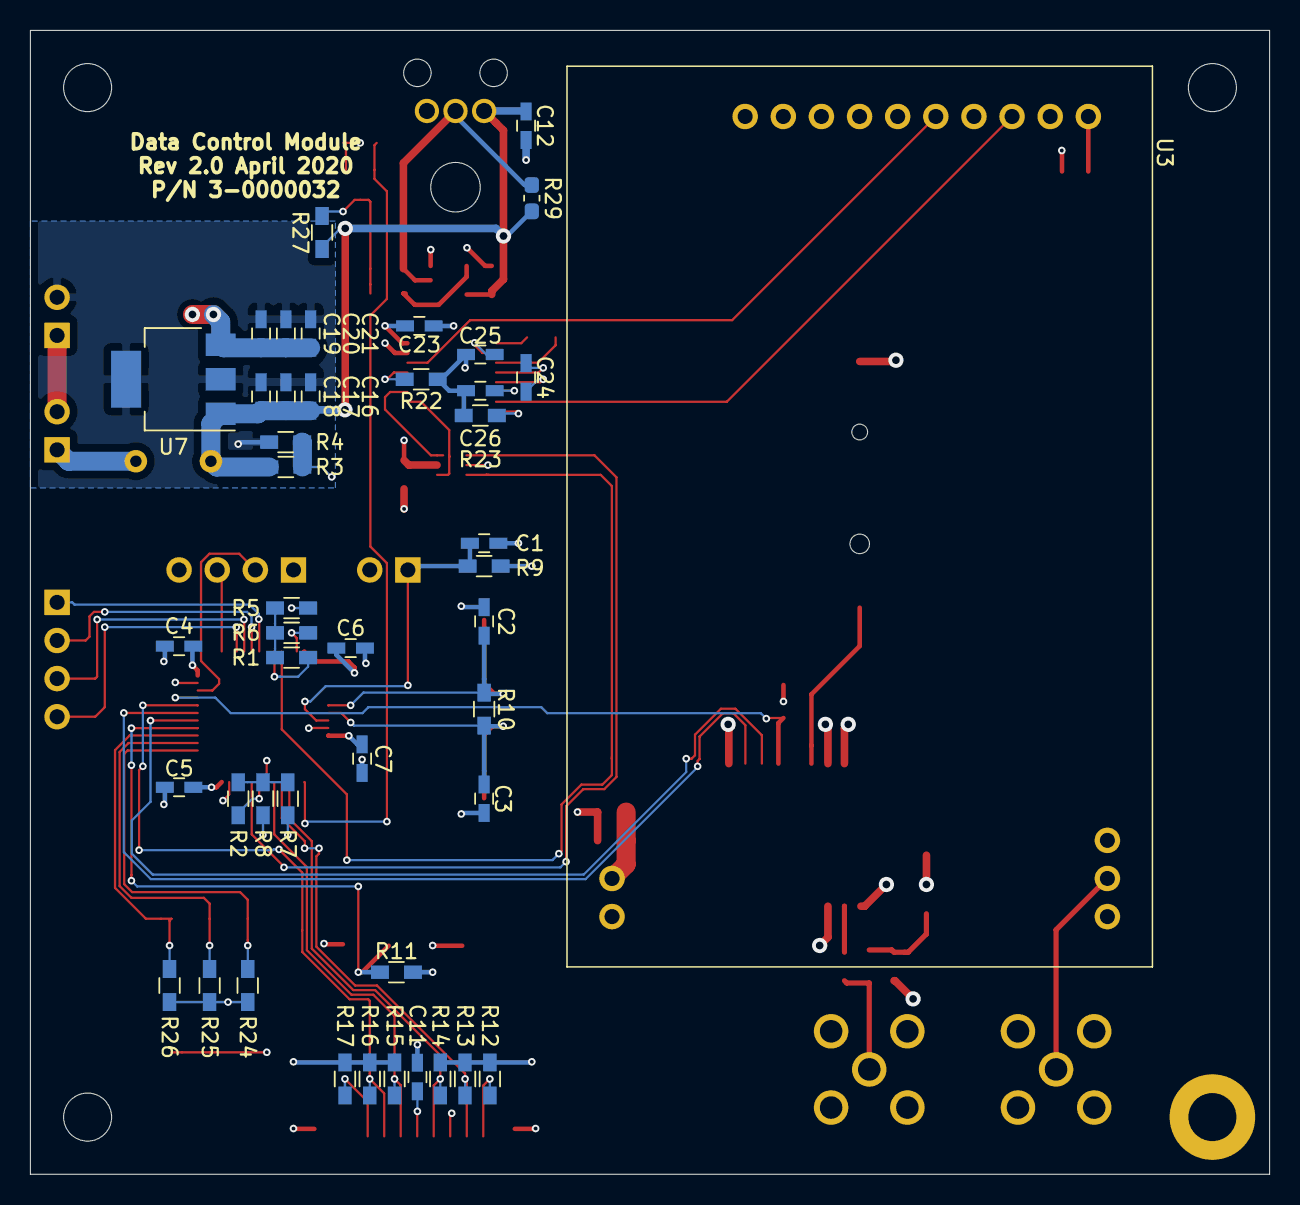
[picture p42: board control_pcb.kicad_pcb from below]

Board: 4 copper layers, 82.6 x 76.2 mm, 86 parts (45 on the bottom side), 56 nets.

Parts:
AE1, AE2: Antenna_Shield; SMA
BT1: CR1220; S8411-45R
C1, C10, C17, C20: 1u; C_0603_HandSoldering
C2, C3: 20pF; C_0603_HandSoldering
C4, C5, C6, C7, C8, C11, C12, C13, C18, C21, C22, C23, C24, C25, C26: 0.1u; C_0603_HandSoldering
C9, C16, C19: 10u; C_0603_HandSoldering
C14: 47pF; C_0603_HandSoldering
C15: 10nF; C_0603_HandSoldering
F1: Polyfuse; RGEF250
FID1, FID2, FID3, FID4: Fiducial; Fiducial_0.75mm_Dia_1.5mm_Outer
H1, H2, H3: MountingHole; MountingHole_3.2mm_M3_ISO7380
H4: MountingHole; MountingHole_3.2mm_M3_ISO7380_Pad
J1: Conn_01x02; Pin_Header_Straight_1x02_Pitch2.54mm
J2: ISP; Pin_Header_Straight_1x04_Pitch2.54mm
J3: Spare; Pin_Header_Straight_1x04_Pitch2.54mm
J5: Micro_SD_Card_Det; HRS_DM3CS-SF
J6: Battery; Pin_Header_Straight_1x02_Pitch2.54mm
J7: External Switch; Pin_Header_Straight_1x02_Pitch2.54mm
L1: 27nH; R_0603_HandSoldering
Q1: BSS138; SOT-23
R1, R2, R11, R12, R13, R15, R16, R17: 100k; R_0603_HandSoldering
R3: 27k; R_0603_HandSoldering
R4, R9, R22, R23, R24, R25, R26, R27, R28: 10k; R_0603_HandSoldering
R5, R7, R14, R18, R20: NP; R_0603_HandSoldering
R6, R8, R19: 0R0; R_0603_HandSoldering
R10: 1M; R_0603_HandSoldering
R21: 10; R_1218_HandSoldering
R29: 10k; R_0603_1608Metric_Pad1.05x0.95mm_HandSolder
R30: NP; R_0603_1608Metric_Pad1.05x0.95mm_HandSolder
SW1: Freq Select; KAE03TGGR
U1: STM32F103CBT6; LQFP-48_7x7mm_Pitch0.5mm
U2: SN74LVC1G18; SN74LVC1G18DCKR
U3: TX2M-400-5-NSSL; TX2M
U4: IF-D96F
U5: TC4S584F; SOT753
U6: MAX-M8C; XCVR_MAX-M8C-0-10
U7: LT1521-3.3; SOT-223-3_TabPin2
U8: MAX3232; TSSOP-16_4.4x5mm_Pitch0.65mm
Y1: 8MHz; Crystal_SMD_HC49-SD_HandSoldering

Connections:
+3V3: C4.2, C5.2, C6.2, C7.2, C8.1, C11.2, C19.1, C20.1, C21.1, C23.2, J2.1, J5.4, Q1.1, R5.2, R7.2, R9.1, R11.1, R12.1, R13.1, R14.1, R15.1, R16.1, R17.1, R20.2, R21.1, R24.1, R25.1, R26.1, R28.1, U1.9, U1.24, U1.36, U1.48, U2.5, U6.7, U6.8, U7.3, U8.16
+BATT: C9.1, C10.1, C12.1, C13.1, C16.1, C17.1, C18.1, F1.1, R3.1, R27.1, R29.1, U3.1A, U4.3, U5.5, U7.1
/Boot0: R1.2, U1.44
/Boot1: R2.2, U1.19
/Reset: C1.1, J1.1, R9.2, U1.7
/SWCLK: J2.3, U1.37
/SWDIO: J2.2, U1.34
/VBat_Sense: R3.2, R4.1, U1.18
/radio/Data_RS232: U3.8C, U8.7
/radio/Programming_RS232: U3.6C, U8.14
Fiber_Serial_In: Q1.2, R28.2, U1.13
GND: AE1.2, AE2.2, BT1.2, C1.2, C2.2, C3.2, C4.1, C5.1, C6.1, C7.1, C8.2, C9.2, C10.2, C11.1, C12.2, C13.2, C15.1, C16.2, C17.2, C18.2, C19.2, C20.2, C21.2, C23.1, C25.1, C26.1, H4.1, J1.2, J2.4, J5.6, J5.S1, J5.S2, J5.S3, J5.S5, J6.2, R4.2, R6.1, R8.1, R22.1, R23.1, R30.1, SW1.1, SW1.2, SW1.3, U1.8, U1.23, U1.35, U1.47, U2.2, U3.1B, U3.1C, U3.2A, U3.2C, U3.3B, U3.7C, U4.1, U5.3, U6.1, U6.10, U6.12, U7.2, U8.15
GPS_PPS: R20.1, U1.33, U6.4
unnamed: AE1.1, U3.2B
unnamed: AE2.1, C14.1, L1.1
unnamed: BT1.1, U6.6
unnamed: C2.1, R10.1, U1.5, Y1.1
unnamed: C3.1, R10.2, U1.6, Y1.2
unnamed: C14.2, U6.11
unnamed: C15.2, L1.2, R21.2
unnamed: C22.1, U8.1
unnamed: C22.2, U8.3
unnamed: C24.1, U8.4
unnamed: C24.2, U8.5
unnamed: C25.2, U8.2
unnamed: C26.2, U8.6
unnamed: F1.2, J7.1
unnamed: J3.1, U1.42
unnamed: J3.2, U1.41
unnamed: J3.3, U1.40
unnamed: J3.4, U1.39
unnamed: J5.1, R17.2
unnamed: J5.8, R12.2
unnamed: J6.1, J7.2
unnamed: Q1.3, R18.1, R19.1, R27.2
unnamed: R1.1, R5.1, R6.2
unnamed: R2.1, R7.1, R8.2
unnamed: R18.2, U5.4
unnamed: R19.2, R29.2, U4.2, U5.2
unnamed: R22.2, U8.13
unnamed: R23.2, U8.8
unnamed: R24.2, SW1.6, U1.26
unnamed: R25.2, SW1.5, U1.27
unnamed: R26.2, SW1.4, U1.28
unnamed: R30.2, U3.10C
unnamed: U2.4, U8.10
unnamed: U2.6, U8.11
RX_from_GPS: U1.31, U6.2
Radio_Serial_Select: U1.20, U2.1
SD_CS: J5.2, R16.2, U1.32
SD_DETECT: J5.9, R11.2, U1.29
SPI1_MISO: J5.7, R13.2, U1.16
SPI1_MOSI: J5.3, R15.2, U1.17
SPI1_SCLK: J5.5, R14.2, U1.15
TX_to_GPS: U1.30, U6.3
TX_to_Radio: U1.45, U2.3
