jrleeman/NSSL_EFM/Hardware/Cutdown_PCB/KiCAD_Project/cutdown/cutdown.kicad_pcb

## KiCad design Hardware/Cutdown_PCB/KiCAD_Project/cutdown/cutdown.kicad_pcb (2020-03-30)

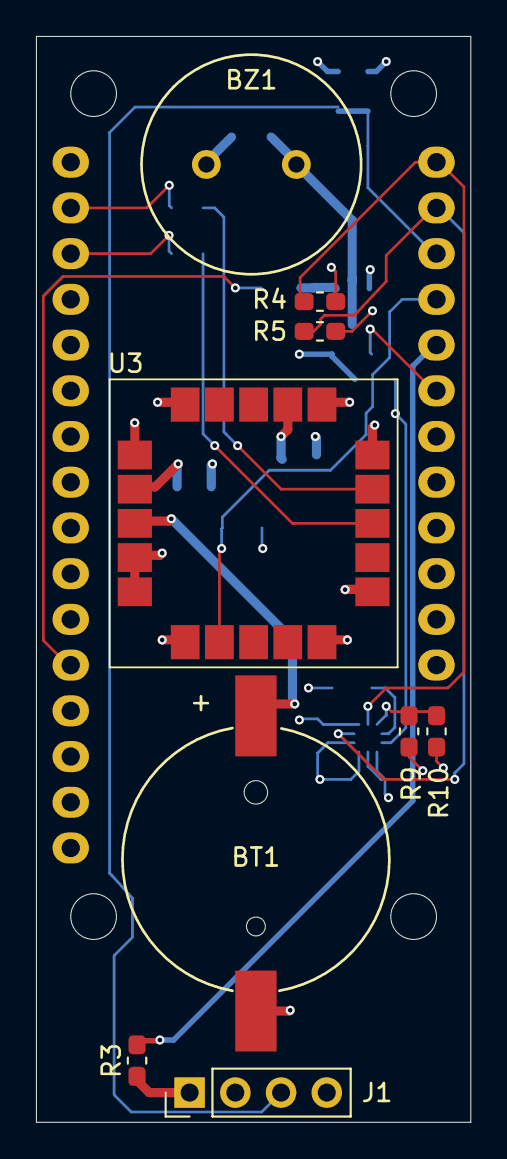
[picture p43: board cutdown.kicad_pcb from above]

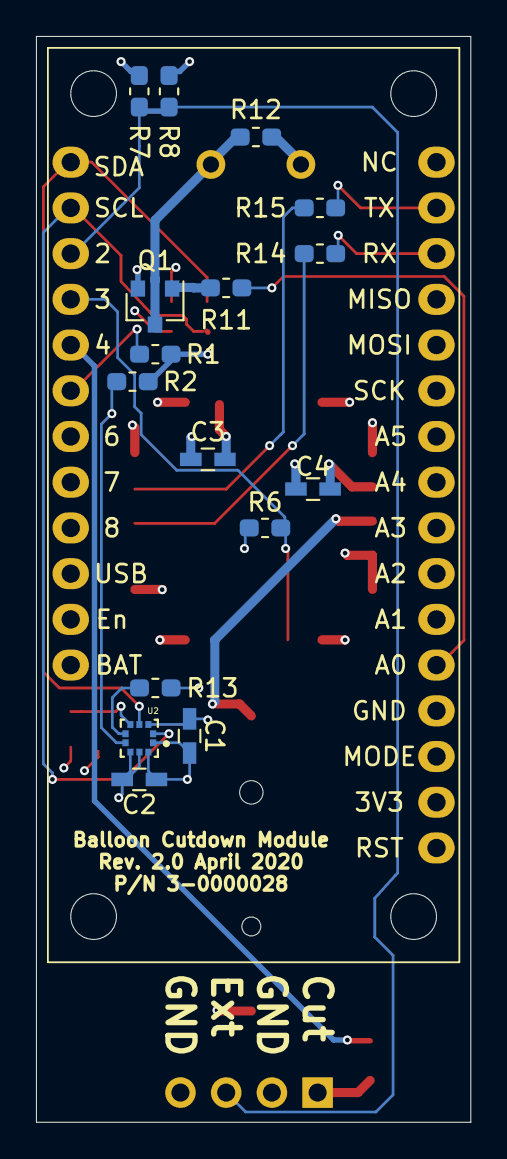
[picture p44: board cutdown.kicad_pcb from below]

Board: 4 copper layers, 24.1 x 60.3 mm, 26 parts (17 on the bottom side), 20 nets.

Parts:
BT1: CR1220; S8411-45R
BZ1: Buzzer; PS1240P02BT
C1, C2, C3, C4: 0.1u; C_0603_HandSoldering
J1: Nichrome Wire; Pin_Header_Straight_1x04_Pitch2.54mm
Q1: MMBT3904; SOT-23
R1, R2, R4, R5, R6, R7, R10, R13: 10k; R_0603_1608Metric_Pad1.05x0.95mm_HandSolder
R3, R14, R15: 0R0; R_0603_1608Metric_Pad1.05x0.95mm_HandSolder
R8, R9: NP; R_0603_1608Metric_Pad1.05x0.95mm_HandSolder
R11, R12: 1k; R_0603_1608Metric_Pad1.05x0.95mm_HandSolder
U1: Particle
U2: BMP388; PQFN50P200X200X80-10N
U3: ublox_SAM-M8Q; SAM-M8Q

Connections:
+3V3: BZ1.1, C1.1, C2.2, C3.2, C4.2, R1.1, R2.1, R4.1, R5.1, R6.1, R7.1, R9.1, R12.1, R13.1, U1.2, U2.1, U2.10, U3.2, U3.17
+BATT: BT1.1, U3.3
BMP388_INT: R2.2, U1.22, U2.7
BMP388_SDO: R1.2, U1.23
CUTOFF_LOGIC: R3.2, U1.24
EXT_CUTDOWN: J1.3, R7.2, R8.2, U1.26
GND: BT1.2, C1.2, C2.1, C3.1, C4.1, J1.2, J1.4, Q1.2, R8.1, R10.2, U1.4, U2.3, U2.8, U2.9, U3.1, U3.4, U3.5, U3.6, U3.10, U3.11, U3.15, U3.16, U3.20
GPS_PPS: R6.2, U1.25, U3.7
GPS_RX: R15.2, U3.14
GPS_TX: R14.2, U3.13
unnamed: BZ1.2, Q1.3, R12.2
unnamed: J1.1, R3.1
unnamed: Q1.1, R11.1
unnamed: R9.2, R10.1, U2.5
unnamed: R13.2, U2.6
unnamed: R14.1, U1.14
unnamed: R15.1, U1.15
PIEZO_ELEMENT: R11.2, U1.5
SCL: R5.2, U1.27, U2.2
SDA: R4.2, U1.28, U2.4
