jrleeman/NSSL_EFM/Hardware/Analog_PCB/KiCAD_Project/analog_pcb/analog_pcb.kicad_pcb

## KiCad design Hardware/Analog_PCB/KiCAD_Project/analog_pcb/analog_pcb.kicad_pcb (2020-01-01)

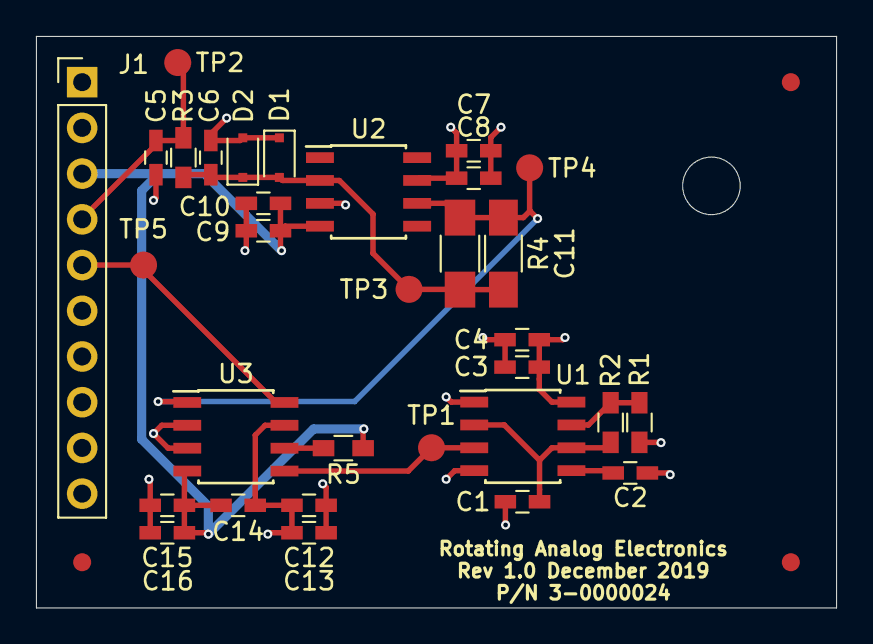
[picture p45: board analog_pcb.kicad_pcb from above]

Board: 4 copper layers, 44.4 x 31.8 mm, 36 parts (0 on the bottom side), 12 nets.

Parts:
C1, C4, C8, C9, C13, C16: 0.1u; C_0603_HandSoldering
C2: 0.01u; C_0603_HandSoldering
C3, C7, C10, C12, C14, C15: 1u; C_0603_HandSoldering
C5, C6: 0.39nF; C_0603_HandSoldering
C11: 0.1u; C_1206_HandSoldering
D1, D2: 1N4148; D_SOD-323F
FID1, FID2, FID3: Fiducial; Fiducial_1mm_Dia_2mm_Outer
H1: MountingHole; MountingHole_3.2mm_M3_ISO7380
J1: Board to Board; Pin_Header_Straight_1x10_Pitch2.54mm
R1, R3: 100; R_0603_HandSoldering
R2: 4.75k; R_0603_HandSoldering
R4: 100M; R_1206_HandSoldering
R5: 10k; R_0603_HandSoldering
TP1, TP2, TP3, TP4, TP5: TestPoint; Measurement_Point_Round-SMD-Pad_Small
U1: 555; SOIC-8_3.9x4.9mm_Pitch1.27mm
U2: LF356; SOIC-8_3.9x4.9mm_Pitch1.27mm
U3: LTC1569-6; SOIC-8_3.9x4.9mm_Pitch1.27mm

Connections:
+5V: C3.1, C4.1, C7.1, C8.1, C12.1, C13.1, C14.1, J1.2, R1.1, U1.4, U1.8, U2.7, U3.7
-5V: C9.1, C10.1, C14.2, C15.2, C16.2, J1.3, R5.1, U2.4, U3.4
FCLK: TP1.1, U1.3, U3.5
GND: C1.1, C2.1, C3.2, C4.2, C5.2, C6.2, C7.2, C8.2, C9.2, C10.2, C12.2, C13.2, C15.1, C16.1, D1.1, D2.2, J1.1, J1.6, U1.1, U2.3, U3.2, U3.3
In: C5.1, J1.4, R3.2, TP2.1
unnamed: C1.2, R2.2, U1.2, U1.6
unnamed: C2.2, U1.5
unnamed: C11.1, R4.1, TP4.1, U2.6, U3.1
unnamed: C6.1, C11.2, D1.2, D2.1, R3.1, R4.2, TP3.1, U2.2
unnamed: R1.2, R2.1, U1.7
unnamed: R5.2, U3.6
Out: J1.5, TP5.1, U3.8
