jrleeman/NSSL_EFM/Hardware/Cutdown_Power_PCB/KiCAD_Project/cutdown_power/cutdown_power.kicad_pcb

## KiCad design Hardware/Cutdown_Power_PCB/KiCAD_Project/cutdown_power/cutdown_power.kicad_pcb (2019-12-31)

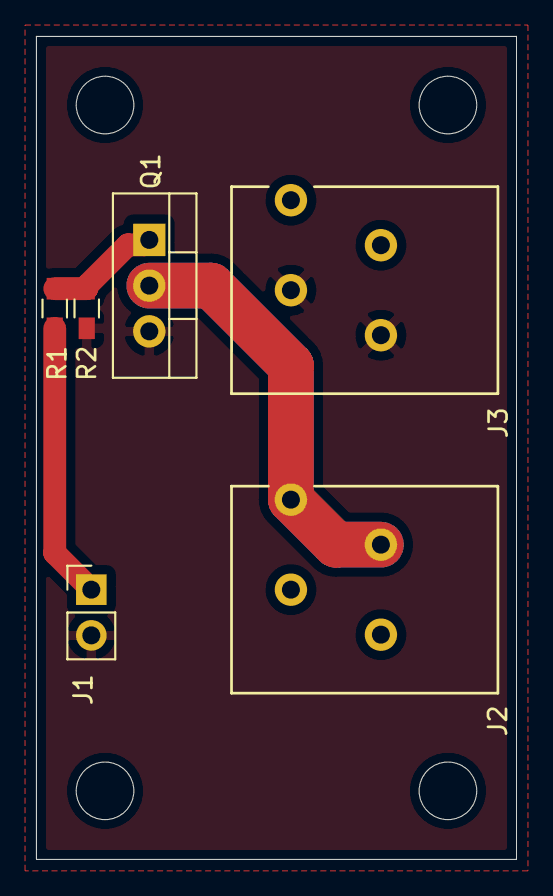
[picture p46: board cutdown_power.kicad_pcb from above]

Board: 2 copper layers, 26.7 x 45.7 mm, 10 parts (0 on the bottom side), 5 nets.

Parts:
H1, H2, H3, H4: MountingHole; MountingHole_3.2mm_M3_ISO7380
J1: Control Signal; Pin_Header_Straight_1x02_Pitch2.54mm
J2: Heater Coil; 1986711-2
J3: Battery Pack; 1986711-2
Q1: FQP30N06L; TO-220-3_Vertical
R1: 0R0; R_0603_HandSoldering
R2: 10k; R_0603_HandSoldering

Connections:
GND: J1.2, J3.1, Q1.3, R2.2
unnamed: J1.1, R1.2
unnamed: J2.1, J3.2
unnamed: J2.2, Q1.2
unnamed: Q1.1, R1.1, R2.1
