jrleeman/NSSL_EFM/Hardware/Motor_Control_PCB/KiCAD_Project/motor_control/motor_control.kicad_pcb

## KiCad design Hardware/Motor_Control_PCB/KiCAD_Project/motor_control/motor_control.kicad_pcb (2019-12-06)

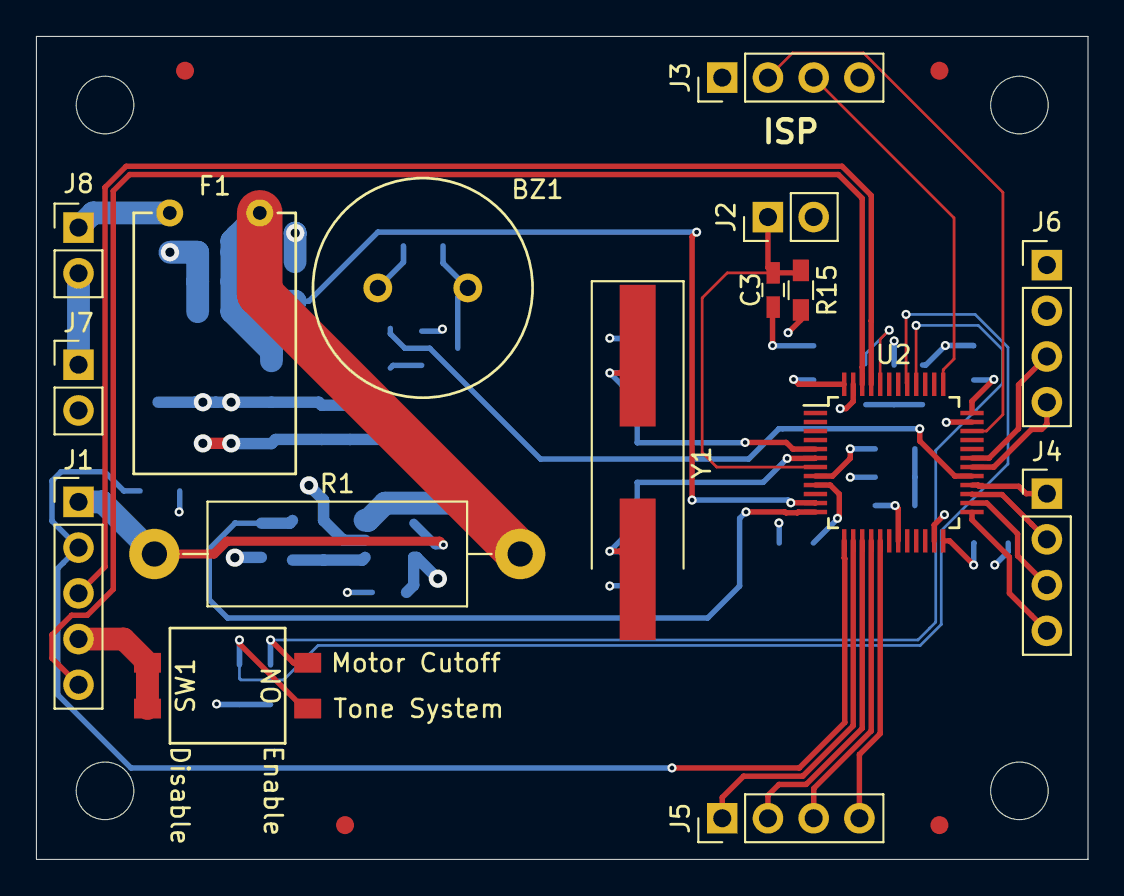
[picture p47: board motor_control.kicad_pcb from above]

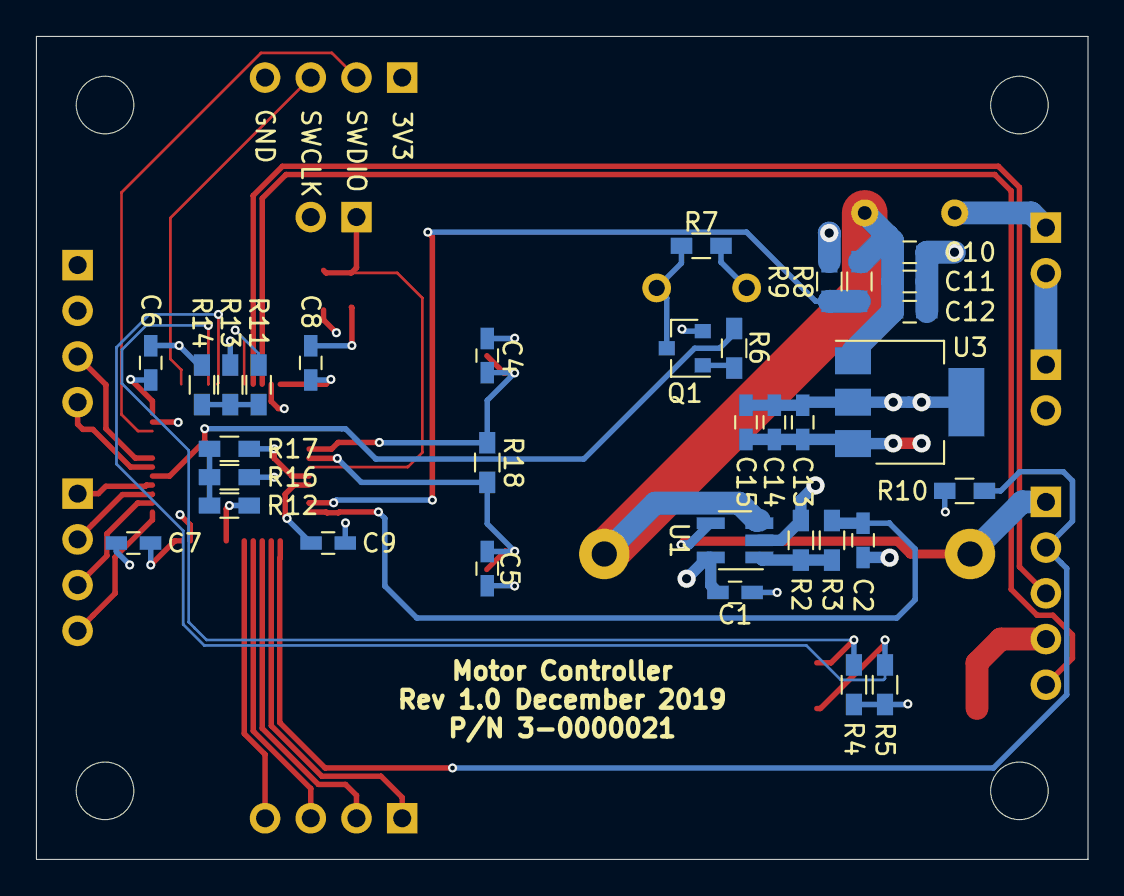
[picture p48: board motor_control.kicad_pcb from below]

Board: 4 copper layers, 58.4 x 45.7 mm, 57 parts (33 on the bottom side), 36 nets.

Parts:
BZ1: Piezo; PS1240P02BT
C1, C2, C6, C7, C8, C9, C12, C15: 0.1u; C_0603_HandSoldering
C3, C11, C14: 1u; C_0603_HandSoldering
C4, C5: 20pF; C_0603_HandSoldering
C10, C13: 10u; C_0603_HandSoldering
F1: Polyfuse; RGEF250
FID1, FID2, FID3, FID4: Fiducial; Fiducial_1mm_Dia_2.54mm_Outer_CopperTop
H1, H2, H3, H4: MountingHole; MountingHole_3.2mm_M3_ISO7380
J1: Motor; Pin_Header_Straight_1x05_Pitch2.54mm
J2: Conn_01x02; Pin_Header_Straight_1x02_Pitch2.54mm
J3: ISP; Pin_Header_Straight_1x04_Pitch2.54mm
J4: Spares 2; Pin_Header_Straight_1x04_Pitch2.54mm
J5: Spares 1; Pin_Header_Straight_1x04_Pitch2.54mm
J6: UART1; Pin_Header_Straight_1x04_Pitch2.54mm
J7: Battery; Pin_Header_Straight_1x02_Pitch2.54mm
J8: External Power Switch; Pin_Header_Straight_1x02_Pitch2.54mm
Q1: MMBT3904; SOT-23
R1: 1; R_Axial_DIN0614_L14.3mm_D5.7mm_P20.32mm_Horizontal
R2, R4, R5, R9, R15: 10k; R_0603_HandSoldering
R3, R18: 1M; R_0603_HandSoldering
R6, R7: 1k; R_0603_HandSoldering
R8: 27k; R_0603_HandSoldering
R10, R13, R16: NP; R_0603_HandSoldering
R11, R12: 100k; R_0603_HandSoldering
R14, R17: 0R0; R_0603_HandSoldering
SW1: Configuration; KAE02LGGR
U1: INA169; SOT-23-5_HandSoldering
U2: STM32F103CBT6; LQFP-48_7x7mm_Pitch0.5mm
U3: LT1521-3.3; SOT-223-3_TabPin2
Y1: 8MHz; Crystal_SMD_HC49-SD_HandSoldering

Connections:
+3V3: BZ1.1, C1.2, C6.1, C7.1, C8.1, C9.1, C13.1, C14.1, C15.1, J3.1, R4.1, R5.1, R7.1, R10.1, R13.2, R15.2, R16.2, U1.5, U2.9, U2.24, U2.36, U2.48, U3.3
+BATT: C10.1, C11.1, C12.1, F1.1, R1.2, R8.1, U1.3, U3.1
/microcontroller/Boot0: R11.2, U2.44
/microcontroller/Boot1: R12.2, U2.19
/microcontroller/Reset: C3.2, J2.1, R15.1, U2.7
/microcontroller/SWCLK: J3.3, U2.37
/microcontroller/SWDIO: J3.2, U2.34
Current_Sense: C2.2, R3.2, U2.12
GND: C1.1, C2.1, C3.1, C4.2, C5.2, C6.2, C7.2, C8.2, C9.2, C10.2, C11.2, C12.2, C13.2, C14.2, C15.2, J1.4, J2.2, J3.4, J6.1, J7.2, Q1.2, R2.2, R9.2, R14.1, R17.1, SW1.1, SW1.2, U1.2, U2.8, U2.23, U2.35, U2.47, U3.2
Motor_Cutoff_Enable: R4.2, SW1.4, U2.40
Motor_Direction: J1.3, U2.45
Motor_Encoder: J1.2, R10.2, U2.13
Motor_PWM: J1.5, U2.46
unnamed: BZ1.2, Q1.3, R7.2
unnamed: C4.1, R18.1, U2.5, Y1.1
unnamed: C5.1, R18.2, U2.6, Y1.2
unnamed: F1.2, J8.1
unnamed: J1.1, R1.1, U1.4
unnamed: J4.1, U2.28
unnamed: J4.2, U2.27
unnamed: J4.3, U2.26
unnamed: J4.4, U2.25
unnamed: J5.1, U2.14
unnamed: J5.2, U2.15
unnamed: J5.3, U2.16
unnamed: J5.4, U2.17
unnamed: J7.1, J8.2
unnamed: Q1.1, R6.1
unnamed: R2.1, R3.1, U1.1
unnamed: R11.1, R13.1, R14.2
unnamed: R12.1, R16.1, R17.2
Piezo: R6.2, U2.29
Tone_System_Enable: R5.2, SW1.3, U2.41
UART1_RX: J6.3, U2.31
UART1_TX: J6.4, U2.30
VBAT_Sense: R8.2, R9.1, U2.11
