jrleeman/NSSL_EFM/Hardware/Battery_PCB/KiCAD_Project/battery_pack/battery_pack.kicad_pcb

## KiCad design Hardware/Battery_PCB/KiCAD_Project/battery_pack/battery_pack.kicad_pcb (2019-12-06)

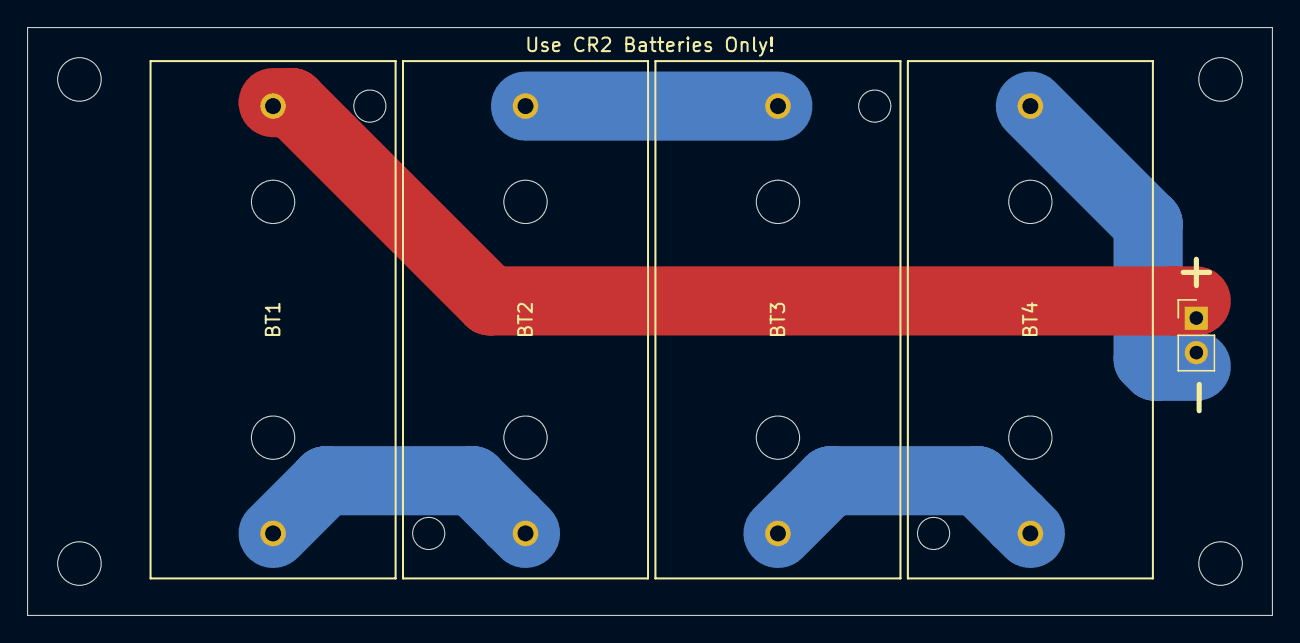
[picture p49: board battery_pack.kicad_pcb from above]

Board: 2 copper layers, 91.4 x 43.2 mm, 9 parts (0 on the bottom side), 5 nets.

Parts:
BT1, BT2, BT3, BT4: CR2; BH-CR2-PC
H1, H2, H3, H4: MountingHole; MountingHole_3.2mm_M3_ISO7380
J1: Conn_01x02; Pin_Header_Straight_1x02_Pitch2.54mm

Connections:
unnamed: BT1.1, J1.1
unnamed: BT1.2, BT2.1
unnamed: BT2.2, BT3.1
unnamed: BT3.2, BT4.1
unnamed: BT4.2, J1.2
