jrleeman/NSSL_EFM/(commit log)

2019-12-06 Initial design of battery pack PCB
    [battery_pack-B_Cu.gbr, battery_pack-B_Mask.gbr, battery_pack-B_Paste.gbr, battery_pack-B_SilkS.gbr, battery_pack-Edge_Cuts.gbr, battery_pack-F_Cu.gbr, battery_pack-F_Mask.gbr, battery_pack-F_Paste.gbr]
2019-12-06 Initial design of cutdown control PCB.
    [cutdown-B_Cu.gbr, cutdown-B_Mask.gbr, cutdown-B_Paste.gbr, cutdown-B_SilkS.gbr, cutdown-Edge_Cuts.gbr, cutdown-F_Cu.gbr, cutdown-F_Mask.gbr, cutdown-F_Paste.gbr]
2019-12-06 Initial design of cutdown power PCB.
    [cutdown_power-B_Cu.gbr, cutdown_power-B_Mask.gbr, cutdown_power-B_Paste.gbr, cutdown_power-B_SilkS.gbr, cutdown_power-Edge_Cuts.gbr, cutdown_power-F_Cu.gbr, cutdown_power-F_Mask.gbr, cutdown_power-F_Paste.gbr]
2019-12-06 Initial design of motor control PCB.
    [Power.sch, microcontroller.sch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]
2019-12-06 Initial design of the control PCB.
    [GPS.sch, Power.sch, control_pcb.kicad_pcb, control_pcb.sch, fiber.sch, radio.sch, sd.sch]
2019-12-30 Draft of rotating analog electronics.
    [analog_pcb.kicad_pcb, analog_pcb.sch]
2019-12-30 Control PCB Rev 1.0 complete.
    [Power.sch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]
2019-12-30 Cutdown PCB Rev 1.0 Complete.
    [cutdown-B_Cu.gbr, cutdown-B_Mask.gbr, cutdown-B_Paste.gbr, cutdown-B_SilkS.gbr, cutdown-Edge_Cuts.gbr, cutdown-F_Cu.gbr, cutdown-F_Mask.gbr, cutdown-F_Paste.gbr]
2019-12-30 Update part numbers. Motor control Rev 1.0 complete.
    [Power.sch]
2019-12-30 Digital rotating electronics draft complete.
    [ADC.sch, Fiber.sch, Peripherals.sch, Power.sch, digital_pcb.kicad_pcb, digital_pcb.sch]
2019-12-30 Add pullups and divider for ADC input.
    [ADC.sch, Peripherals.sch, digital_pcb.kicad_pcb, digital_pcb.sch]
2019-12-31 Fix reversed Q1 issue and cut Rev 1.1
    [cutdown_power-B_Cu.gbr, cutdown_power-B_Mask.gbr, cutdown_power-B_Paste.gbr, cutdown_power-B_SilkS.gbr, cutdown_power-Edge_Cuts.gbr, cutdown_power-F_Cu.gbr, cutdown_power-F_Mask.gbr, cutdown_power-F_Paste.gbr]
2020-01-01 Analog PCB Rev 1.0 complete.
    [analog_pcb-B_Cu.gbr, analog_pcb-B_Mask.gbr, analog_pcb-B_Paste.gbr, analog_pcb-B_SilkS.gbr, analog_pcb-Edge_Cuts.gbr, analog_pcb-F_Cu.gbr, analog_pcb-F_Mask.gbr, analog_pcb-F_Paste.gbr]
2020-01-01 Digital PCB Rev 1.0 complete.
    [ADC.sch, Fiber.sch, Peripherals.sch, Power.sch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]
2020-01-01 Motor control firmware draft complete.
2020-03-30 Get updated with current status.
2020-03-30 Fix GPS connection to particle.
    [cutdown.kicad_pcb, cutdown.sch, peripherals.sch]
2020-03-31 Fix flipped fiber transmtter footprint, closes #4.
    [digital_pcb.kicad_pcb]
2020-03-31 Update IMU crystal footprint to 4-SOJ. closes #5.
    [ADC.sch, Fiber.sch, Peripherals.sch, Power.sch, digital_pcb.kicad_pcb, digital_pcb.sch]
2020-03-31 Debounce power switch with load switch and RC timer. Closes #1.
    [Fiber.sch, Power.sch, digital_pcb.kicad_pcb]
2020-03-31 Update footprints for R32 and fix various small layout things and silk screen.
    [Fiber.sch, digital_pcb.kicad_pcb]
2020-03-31 Change to sending binary packets from the PCB
2020-03-31 Fixup DRC issues.
    [Power.sch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]
2020-03-31 Add pullup to fiber optic receiver. Closes #12.
    [GPS.sch, Power.sch, control_pcb.kicad_pcb, control_pcb.sch, fiber.sch, radio.sch, sd.sch]
2020-03-31 Fix TX2M footprint. Closes #2
    [control_pcb.kicad_pcb]
2020-03-31 Change UARTS for separate radio serial.
    [control_pcb.kicad_pcb, control_pcb.sch, radio.sch]
2020-03-31 Update production files for Rev 2.0
    [GPS.sch, Power.sch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]
2020-03-31 Production files for digital rotating PCB.
    [digital_pcb-B_Cu.gbr, digital_pcb-B_Mask.gbr, digital_pcb-B_Paste.gbr, digital_pcb-B_SilkS.gbr, digital_pcb-Edge_Cuts.gbr, digital_pcb-F_Cu.gbr, digital_pcb-F_Mask.gbr, digital_pcb-F_Paste.gbr]
2020-12-17 Fix power silk screen. Closes #16
    [digital_pcb.kicad_pcb]
2020-12-17 Swap sensor from T/RH to T/RH/P and update schematic version.
    [Peripherals.sch, digital_pcb.sch]
2020-12-17 Update schematic to use ATTINY for filter frequency generation.
    [analog_pcb.sch]
